IbrahimAyoub05/AIglasses/Cad Designs/Hero Models/Screenshot 2026-05-05 at 3.56.49 PM.png

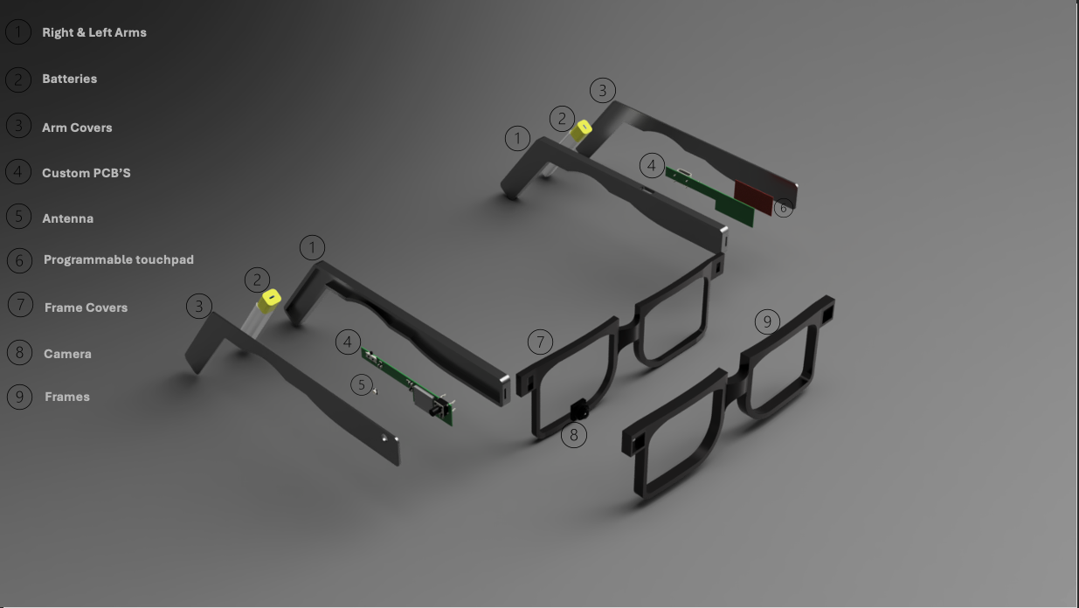
Cad Designs/Hero Models/Screenshot 2026-05-05 at 3.56.49 PM.png
