IbrahimAyoub05/AIglasses/Cad Designs/Older/Glasses 3D Design 1/Ibrahim Ayoub ECE Plan of Study copy.xlsx

Sheet: 4 yrs, 1 co-op (spring) (2)
 | B.S. in Electrical and Computer Engineering |  |  | CURRICULUM PLANNER |  | DEGREE CLEARANCE FORM
 | 4 years, 1 co-op in Spring/Summer 1 [DA Pattern] |  | > Hover over a course to view prerequisites, frequency, and other advising notes. |  |  | >After pasting completed courses into the Degree Clearance Form, fill in the grade and credits earned.
 | This sheet is a planning tool, but is not meant to substitute for the degree audit and catalog. It is the student's responsibility to check their degree audit to ensure that degree requirements are being met.
 | Please refer to the academic catalog for more detailed information on each course (https://catalog.northeastern.edu/) |  | > Cut and paste course cells if moving to a different semester |  |  | > Transfer credit grades: College = 'T', Advanced Placement = 'AP', International Baccalaureate = 'IB'
 | Name: Ibrahim Ayoub |  | > Cut and paste course cells into the Degree Clearance Form when completed
 | Student ID: |  |  |  |  | > Be sure to accurately indicate total Northeastern credits awarded for transfer and study abroad courses.
 | Year of Graduation: |  | > Before making any changes, read important advising notes at bottom of document.
 | Capstone: |  |  |  |  | > Input course numbers for all elective coursework
 | FALL (YEAR) | SPRING | SUMMER 1 | SUMMER 2 |  | MATH & SCIENCE |  | GRADE | TOTAL CREDITS | MATH/SCI CREDITS | ENG'G CREDITS
 | NOTES: | NOTES: | NOTES: | NOTES:
YEAR 1 |  |  |  |  | YEAR 1 | CHEM1151 > | CHEM1151 Chem for Eng. 4cr |  |  | 4
 |  |  |  |  |  | CHEM1153 > | CHEM1153 Recitation
 |  |  |  |  |  | CS1800 > |  |  |  | 4
 |  |  |  |  |  | CS1802 > |  |  |  | 1
 |  |  |  |  |  | MATH1341 > | MATH1341 Calc 1 for Eng. 4cr |  |  | 4
 |  |  |  |  |  | MATH1342 > | MATH1342 Calc 2 for Eng. 4cr |  |  | 4
 |  |  |  |  |  | MATH2321 > | MATH2321 Calc 3 for Eng. 4cr |  |  | 4
 |  |  |  |  |  | MATH2341 > | MATH2341 Diff Eq/Lin. Alg. 4cr |  |  | 4
 | FALL | SPRING | SUMMER 1 | SUMMER 2 |  | PHYS1151 > | PHYS1151 Phys 1 for Eng. 3cr |  |  | 3
 | NOTES: | NOTES: | NOTES: | NOTES: |  | PHYS1152 > | PHYS1152 Phys 1 lab 1cr |  |  | 1
YEAR 2 |  |  |  |  | YEAR 2 | PHYS1153 > | PHYS1153 Physics ILS 1cr |  |  | 1
 |  |  |  |  |  | PHYS1155 > | PHYS1155 Phys 2 for Eng. 3cr |  |  | 3
 |  |  |  |  |  | PHYS1156 > | PHYS1156 Phys 2 lab 1cr |  |  | 1
 |  |  |  |  |  | PHYS1157 > | PHYS1157 Physics 2 ILS 1cr |  |  | 1
 |  |  |  |  |  | ENGI- NEERING |  | GRADE | TOTAL CREDITS | MATH/SCI CREDITS | ENG'G CREDITS
 | FALL | SPRING | SUMMER 1 | SUMMER 2 |  | EECE2140 | EECE2140 Computing Fundamentals for Engineers 4cr |  |  |  | 4
 | NOTES: | NOTES: | NOTES: | NOTES: SUBMIT UPDATED PLAN TO ADVISOR FOR CLEARANCE REVIEW. |  | EECE2150 | EECE2150 Circuits & Signals 5cr |  |  |  | 5
YEAR 3 |  | CO-OP | CO-OP |  | YEAR 3 | EECE2160 | EECE2160 Embedded Design 4cr |  |  |  | 4
 |  |  |  |  |  | Required: 3 EE Fundamentals
 |  |  |  |  |  | EECE2412 | EECE2412/13 Fundamentals of Electronics |  |  |  | 4
 |  |  |  |  |  | EECE2413 lab | EECE2413 lab |  |  |  | 1
 |  |  |  |  |  | EECE2520 | X |  |  |  | 4
 |  |  |  |  |  | EECE2530 | x |  |  |  | 4
 |  |  |  |  |  | EECE2531 lab | x |  |  |  | 1
 |  |  |  |  |  | Required: 3 CE Fundamentals
 | FALL | SPRING | Summer | Fall |  | EECE2322 | x |  |  |  | 4
 | NOTES: | NOTES: | NOTES: | NOTES: |  | EECE2323 lab | x |  |  |  | 1
YEAR 4 | EECE2520 Fundamentals of Linear Systems | EECExxxx EECE Tech Elective 4 4cr | EECE4791 Capstone 1 |  | YEAR 4 | EECE2540 | Fundimentals of netwroks 2540 |  |  |  | 4
 | EECE2322/23 Digital Design |  | XXXX____ > | EECE3468 Noise & Stoch. Pro. 4cr |  | EECE2560 | EECExxxx EE/CE Fund 4/5cr |  |  |  | 4
 | EECE2323 lab | EECExxxx EECE Tech Elective 6 4cr | EECExxxx EECE Tech Elective 5 4cr | EECE4792 Capstone 2 4cr |  | CAPSTONE
 | CS 3200Introduction to Databases 4cr |  | EECE2530 Elctromagnetics | ENCP3000 Prof. Issues 1cr |  | EECE4791 |  |  |  |  | 1
 | EECE2750 Enabiling Engineering 4cr |  | EECE2531 lab |  |  | EECE4792 |  |  |  |  | 4
 |  |  |  |  |  | TECH. ELECT.
 |  |  |  |  |  | EECExxxx |  |  |  |  | 4
 |  |  |  |  |  | EECExxxx |  |  |  |  | 4
 | ADVISING NOTES |  |  |  |  | EECExxxx |  |  |  |  | 4
 |  |  |  |  |  | EECExxxx |  |  |  |  | 4
# | <-- Click to view degree requirements in the catalog, including elective options not specified. |  |  |  |  | ADD'L ENG.
 | > The following NU Path requirements to be completed with General Electives: Interpreting Culture (IC), Difference & Diversity (DD) and Societies & Institutions (SI). |  |  |  |  | GE 1501 > | GE 1501 Cornerstone 1 4cr |  |  |  | 3
 | > Always plan to register for at least 16 credits in a semester (+ required labs/recitations). |  |  |  |  | GE 1502 > | GE 1502 Cornerstone 2 4cr |  |  | 1 | 3
 | > Students with less than 12 billing credits remaining in their curriculum in their final semester are eligible to submit a petition to reduce load |  |  |  |  | EECE3468 |  |  |  | 2 | 2
 | via the StudentHub--> Academics, Classes, and Registration --> Registrar Forms. Submit the petition after registering for final degree requirements.
 | > Keep semester loads balanced. For instance, try to evenly distribute general electives, writing courses and non-engineering coursework.
 | > Course availability as listed is subject to change depending on departmental offerings. Students should always check the projected course offerings
 | as well as the semester schedule prior to registration. |  |  |  |  | PROF. DVLPMT. |  | GRADE | TOTAL CREDITS
 | > This sheet is a planning tool, but is not meant to substitute for the degree audit and catalog. It is the student's responsibility to check their degree audit to ensure
 | that degree requirements are being met. |  |  |  |  | GE 1000 > | GE 1000 First-Year Seminar 1cr
 | >A minimum cumulative GPA requirement of 2.000 in major coursework and a minimum cumulative GPA requirement of 2.000 overall are required for graduation. |  |  |  |  | EECE2000 >
 | Requirements Specific to Combined Electrical & Computer Engr. Majors |  |  |  |  | EECE3000 >
 |  |  |  |  |  | SUPP. COURSES |  | GRADE | TOTAL CREDITS
 | 1. The Capstone Design Courses are taken as follows: (EECE4790 - Summer 1 and EECE4792 - Spring) OR (EECE4790 - Summer 2 and EECE4792 - Fall)
 | 2. For engineering majors, ENGW3315 is an acceptable substitution for ENGW3302. |  |  |  |  | ENGW1111 > | ENGW1111 1st Year Writ. 4cr
 | 3. NUpath requirements, Interpreting Culture (IC), Societies and Institutions (SI) and Differences and Diversity (DD) are not explicitly satisfied by required |  |  |  |  | ENGW3302 >
 | engineering courses. Students are responsible for satisfying these requirements, and if these are not fulfilled in engineering courses, should use General |  |  |  |  | or 3315
 | Electives to do so. General Electives are academic, non-remedial, non-repetitive courses. Should you choose not to pursue a co-op experience, you are
 | required to satisfy the Integration Experience (EX) NUpath requirement through other coursework.
 | 4. Total Required General Elective Credits: 16 |  |  |  |  | GENERAL ELECTIVES | X' the box for each NU Path requirement when it is complete. | GRADE | TOTAL CREDITS | IC | DD | SI
 | 5. Three (3) Required CE Fundamentals:
 | EECE2322/2323 - Fundamentals Digital Design & Lab AND EECE2540 - Fundamentals Networks AND EECE2560 - Fundamentals Algorithms |  |  |  |  | XXXX____ > | XXXX____ Gen Elective 1 4cr |  |  |  | x
 | 6. Three (3) Required EE Fundamentals: |  |  |  |  | XXXX____ > | XXXX____ Gen Elective 2 4cr |  |  | X |  | X
 | EECE2412/2413 - Fundamentals Electronics 1 & lab AND EECE2520 - Fundamentals Linear Systems AND EECE 2530/2531 - Fundamentals Electromagnetics & lab. |  |  |  |  | XXXX____ >
 | 7. Technical Elective Requirements: 2 EECE Technical Electives and 2 Khoury College of Computer Sciences (CS) Technical Electives: |  |  |  |  | XXXX____ >
 | 2 EECE courses from the following approved list: |  |  |  |  |  | ENCP2000 Intro. To Co-op 1cr
 | EECE2750, EECE3154, (EECE3324-EECE3410), ( EECE4512-EECE4698), (EECE4991-EECE4993), (EECE5155-EECE5698), GE4608, ENGR5670
 | 2 CS/CY/IS courses from the following approved list:
 | CY2550, (CS3200-CS3500), (CS3540-CS3800), (CS4100-CY4770), CS4850, (IS4200- IS4700)
 | 8. The registrar’s website provides a listing of degree requirements and the DARS system provides a degree audit utility for students.
 |  |  |  |  |  | MATH/SCIENCE CREDITS |  | MINIMUM |  |  | 30
 |  |  |  |  |  |  |  | EARNED |  |  | 0
 |  |  |  |  |  | ENGINEERING CREDITS |  | REQUIRED |  |  | 68
 | Notes: |  | Minor (optional): |  |  |  |  | EARNED |  |  | 0
 |  |  | Minor Advisor/Email: |  |  | TOTAL CREDITS |  | REQUIRED |  |  | 135
 |  |  | REQUIRED COURSES COMPLETED |  |  |  |  | EARNED |  |  | 0
 |  |  |  |  |  | AP/IB CREDITS
 |  |  |  |  |  | STUDENTS ARE ALLOWED TO COUNT A MAXIMUM OF 32 CREDITS FROM AP/IB COURSES TOWARD TOTAL CREDIT REQUIREMENT. ANY CREDITS OVER THE LIMIT MUST BE MADE UP WITH ADDITIONAL GENERAL ELECTIVE COURSEWORK.
 | REMOTE CAPSTONE DESIGN POLICY |  |  |  |  |  |  | EARNED |  |  | 0
 |  |  |  |  |  |  |  | ALLOWED |  |  | 32
 | The capstone design course is a team effort, and students should try their best to be on-campus working with their team members. Capstone consists of two courses, Capstone 1 (EECE 4790) and Capstone 2 (EECE 4792). Capstone 1 is offered during summer, and it is divided into two sections. Students in the summer 1 section will continue capstone 2 in the spring of the following year and students in the summer 2 section will continue capstone 2 in the fall of the same year. We allow students to take capstone 1 remotely with valid reasoning. However, all students must be on-campus for capstone 2. During the first week of summer 1 or summer 2, we will have an assembly meeting, in which teams are created and advisors are associated with them. Each team consisting of 5 or 6 students is required to meet with the assigned advisor every week for one hour. The advisor usually has five teams and meets with each team at a mutually agreeable time once a week. Note that students will not meet at the designated scheduled classes every day after the first week. However, it is expected that each team arranges more meetings per week (at school or remotely) to be actively involved with the project. |  |  |  |  |  |  | DIFFERENCE
 | The following rules apply for students who are taking capstone remotely:
 | 1. The remote student should submit an email to the Capstone Coordinator, Professor Bahram Shafai (shafai@ece.neu.edu), at least one month before the start of the Capstone 1 term explaining the reason for not being available on campus. Most of the cases can be resolved by communications. | 2. The remote student must attend the assembly meeting(s) in person during the first week before committing to any summer internship, job, family visit or travel. | 3. If the remote student is not available at the assembly meeting(s), the student is responsible for finding a capstone team in advance to represent the student at the meeting. | 4. If the remote student cannot find a complete team, then the student should find one or more students to represent the remote student at the assembly meeting. | 5. The remote student will be placed in a capstone team if this student cannot form a team.
 | 6. The remote student should arrange to be available during the weekly meeting with the capstone advisor and have full agreement from the team that this arrangement is acceptable. | 7. The student should identify personal responsibilities for the capstone team. | 8. The remote student must attend the final proposal presentation in person at the end of the summer session. | 9. If the remote student is not available on-campus for final proposal presentation, then the student can remotely present or integrate their presentation with a short video-clip in the PowerPoint slides. | If there are additional questions or concerns, please contact Professor Bahram Shafai by email: shafai@ece.neu.edu or Cell: (617)721-4805.
 | FALL | SPRING | SUMMER 1 | SUMMER 2
 | NOTES: | NOTES: | NOTES: | NOTES:
YEAR 4 | EECE4791 Capstone 1 1cr | EECE4792 Capstone 2 4cr |  |  | YEAR 4
 | EECExxxx EECE Tech Elective 4 4cr | EECE3468 Noise & Stoch. Pro. 4cr
 | EECExxxx EECE Tech Elective 3 4cr | EECExxxx EE/CE Fund 4/5cr
 |  | EECExxxx EECE Tech Elective 2 4cr
 |  | ENCP3000 Prof. Issues 1cr

Sheet: 4 yrs, 2 co-op (spring)
 | B.S. in Electrical and Computer Engineering |  |  | CURRICULUM PLANNER |  | DEGREE CLEARANCE FORM
 | 4 years, 1 co-op in Spring/Summer 1 [DA Pattern] |  | > Hover over a course to view prerequisites, frequency, and other advising notes. |  |  | >After pasting completed courses into the Degree Clearance Form, fill in the grade and credits earned.
 | This sheet is a planning tool, but is not meant to substitute for the degree audit and catalog. It is the student's responsibility to check their degree audit to ensure that degree requirements are being met.
 | Please refer to the academic catalog for more detailed information on each course (https://catalog.northeastern.edu/) |  | > Cut and paste course cells if moving to a different semester |  |  | > Transfer credit grades: College = 'T', Advanced Placement = 'AP', International Baccalaureate = 'IB'
 | Name: Ibrahim Ayoub |  | > Cut and paste course cells into the Degree Clearance Form when completed
 | Student ID: |  |  |  |  | > Be sure to accurately indicate total Northeastern credits awarded for transfer and study abroad courses.
 | Year of Graduation: |  | > Before making any changes, read important advising notes at bottom of document.
 | Capstone: |  |  |  |  | > Input course numbers for all elective coursework
 | B.S. in Electrical and Computer Engineering |  |  | CURRICULUM PLANNER |  | MATH & SCIENCE |  | GRADE | TOTAL CREDITS | MATH/SCI CREDITS | ENG'G CREDITS
 | 4 years, 1 co-op in Spring/Summer 1 [DA Pattern] |  | > Hover over a course to view prerequisites, frequency, and other advising notes.
YEAR 1 | This sheet is a planning tool, but is not meant to substitute for the degree audit and catalog. It is the student's responsibility to check their degree audit to ensure that degree requirements are being met. |  |  |  |  | CHEM1151 > | CHEM1151 Chem for Eng. 4cr |  |  | 4
 | Please refer to the academic catalog for more detailed information on each course (https://catalog.northeastern.edu/) |  | > Cut and paste course cells if moving to a different semester |  |  | CHEM1153 > | CHEM1153 Recitation
 | Name: Ibrahim Ayoub |  | > Cut and paste course cells into the Degree Clearance Form when completed |  |  | CS1800 > |  |  |  | 4
 | Student ID: |  |  |  |  | CS1802 > |  |  |  | 1
 | Year of Graduation: |  | > Before making any changes, read important advising notes at bottom of document. |  |  | MATH1341 > | MATH1341 Calc 1 for Eng. 4cr |  |  | 4
 | Capstone: |  |  |  |  | MATH1342 > | MATH1342 Calc 2 for Eng. 4cr |  |  | 4
 | FALL (YEAR) | SPRING | SUMMER 1 | SUMMER 2 |  | MATH2321 > |  |  |  | 4
 | NOTES: | NOTES: | NOTES: | NOTES: |  | MATH2341 > |  |  |  | 4
 |  |  |  |  | YEAR 1 | PHYS1151 > | PHYS1151 Phys 1 for Eng. 3cr |  |  | 3
 |  |  |  |  |  | PHYS1152 > | PHYS1152 Phys 1 lab 1cr |  |  | 1
YEAR 2 |  |  |  |  |  | PHYS1153 > | PHYS1153 Physics ILS 1cr |  |  | 1
 |  |  |  |  |  | PHYS1155 > |  |  |  | 3
 |  |  |  |  |  | PHYS1156 > |  |  |  | 1
 |  |  |  |  |  | PHYS1157 > |  |  |  | 1
 | FALL | SPRING | SUMMER 1 | SUMMER 2 |  | ENGI- NEERING |  | GRADE | TOTAL CREDITS | MATH/SCI CREDITS | ENG'G CREDITS
 | NOTES: | NOTES: | NOTES: | NOTES:
 |  |  |  |  | YEAR 2 | EECE2140 |  |  |  |  | 4
 |  |  |  |  |  | EECE2150 |  |  |  |  | 5
YEAR 3 |  |  |  |  |  | EECE2160 |  |  |  |  | 4
 |  |  |  |  |  | Required: 3 EE Fundamentals
 |  |  |  |  |  | EECE2412 |  |  |  |  | 4
 |  |  |  |  |  | EECE2413 lab |  |  |  |  | 1
 |  |  |  |  |  | EECE2520 |  |  |  |  | 4
 |  |  |  |  |  | EECE2530 |  |  |  |  | 4
 | FALL | SPRING | SUMMER 1 | SUMMER 2 |  | EECE2531 lab |  |  |  |  | 1
 | NOTES: | NOTES: | NOTES: | NOTES: SUBMIT UPDATED PLAN TO ADVISOR FOR CLEARANCE REVIEW. |  | Required: 3 CE Fundamentals
 | Fundimentals of netwroks 2540 | EECE2520 Fundamentals of Linear Systems | EECE4791 Capstone 1 |  | YEAR 3 | EECE2322 |  |  |  |  | 4
 | EECE2412/13 Fundamentals of Electronics | EECE2322/23 Digital Design | XXXX____ > |  |  | EECE2323 lab |  |  |  |  | 1
YEAR 4 | EECE2413 lab | EECE2323 lab |  |  |  | EECE2540 |  |  |  |  | 4
 | CS1800 Discrete Structures 4cr | EECExxxx EECE Tech Elective 2 4cr |  |  |  | EECE2560 |  |  |  |  | 4
 | CS1802 Recitation 1cr | EECExxxx EECE Tech Elective 3 4cr |  |  |  | CAPSTONE
 |  | ENCP3000 Prof. Issues 1cr |  |  |  | EECE4791 |  |  |  |  | 1
 |  |  |  |  |  | EECE4792 |  |  |  |  | 4
 |  |  |  |  |  | TECH. ELECT.
 | FALL | SPRING | Fall | Spring |  | EECExxxx |  |  |  |  | 4
 | NOTES: | NOTES: | NOTES: | NOTES: |  | EECExxxx |  |  |  |  | 4
 | EECExxxx EECE Tech Elective 4 4cr | EECE4792 Capstone 2 4cr |  |  | YEAR 4 | EECExxxx |  |  |  |  | 4
 | EECE2530 Elctromagnetics | EECE3468 Noise & Stoch. Pro. 4cr |  |  |  | EECExxxx |  |  |  |  | 4
# | EECE2531 lab | EECExxxx EECE Tech Elective 5 4cr |  |  |  | ADD'L ENG.
 | EECExxxx EECE Tech Elective 6 4cr | ENCP3000 Prof. Issues 1cr |  |  |  | GE 1501 > |  |  |  |  | 3
 |  |  |  |  |  | GE 1502 > |  |  |  | 1 | 3
 |  |  |  |  |  | EECE3468 |  |  |  | 2 | 2
 | > Course availability as listed is subject to change depending on departmental offerings. Students should always check the projected course offerings
 | as well as the semester schedule prior to registration. |  |  |  |  | PROF. DVLPMT. |  | GRADE | TOTAL CREDITS
 | > This sheet is a planning tool, but is not meant to substitute for the degree audit and catalog. It is the student's responsibility to check their degree audit to ensure
 | that degree requirements are being met. |  |  |  |  | GE 1000 > | GE 1000 First-Year Seminar 1cr
 | >A minimum cumulative GPA requirement of 2.000 in major coursework and a minimum cumulative GPA requirement of 2.000 overall are required for graduation. |  |  |  |  | EECE2000 >
 | Requirements Specific to Combined Electrical & Computer Engr. Majors |  |  |  |  | EECE3000 >
 |  |  |  |  |  | SUPP. COURSES |  | GRADE | TOTAL CREDITS
 | 1. The Capstone Design Courses are taken as follows: (EECE4790 - Summer 1 and EECE4792 - Spring) OR (EECE4790 - Summer 2 and EECE4792 - Fall)
 | 2. For engineering majors, ENGW3315 is an acceptable substitution for ENGW3302. |  |  |  |  | ENGW1111 >
 | 3. NUpath requirements, Interpreting Culture (IC), Societies and Institutions (SI) and Differences and Diversity (DD) are not explicitly satisfied by required |  |  |  |  | ENGW3302 >
 | engineering courses. Students are responsible for satisfying these requirements, and if these are not fulfilled in engineering courses, should use General |  |  |  |  | or 3315
 | Electives to do so. General Electives are academic, non-remedial, non-repetitive courses. Should you choose not to pursue a co-op experience, you are
 | required to satisfy the Integration Experience (EX) NUpath requirement through other coursework.
 | 4. Total Required General Elective Credits: 16 |  |  |  |  | GENERAL ELECTIVES | X' the box for each NU Path requirement when it is complete. | GRADE | TOTAL CREDITS | IC | DD | SI
 | 5. Three (3) Required CE Fundamentals:
 | EECE2322/2323 - Fundamentals Digital Design & Lab AND EECE2540 - Fundamentals Networks AND EECE2560 - Fundamentals Algorithms |  |  |  |  | XXXX____ > | XXXX____ Gen Elective 1 4cr
 | 6. Three (3) Required EE Fundamentals: |  |  |  |  | XXXX____ > | XXXX____ Gen Elective 2 4cr |  |  | X |  | X
 | EECE2412/2413 - Fundamentals Electronics 1 & lab AND EECE2520 - Fundamentals Linear Systems AND EECE 2530/2531 - Fundamentals Electromagnetics & lab. |  |  |  |  | XXXX____ >
 | 7. Technical Elective Requirements: 2 EECE Technical Electives and 2 Khoury College of Computer Sciences (CS) Technical Electives: |  |  |  |  | XXXX____ >
 | 2 EECE courses from the following approved list:
 | EECE2750, EECE3154, (EECE3324-EECE3410), ( EECE4512-EECE4698), (EECE4991-EECE4993), (EECE5155-EECE5698), GE4608, ENGR5670
 | 2 CS/CY/IS courses from the following approved list:
 | CY2550, (CS3200-CS3500), (CS3540-CS3800), (CS4100-CY4770), CS4850, (IS4200- IS4700)
 | 8. The registrar’s website provides a listing of degree requirements and the DARS system provides a degree audit utility for students.
 |  |  |  |  |  | MATH/SCIENCE CREDITS |  | MINIMUM |  |  | 30
 |  |  |  |  |  |  |  | EARNED |  |  | 0
 |  |  |  |  |  | ENGINEERING CREDITS |  | REQUIRED |  |  | 68
 | Notes: |  | Minor (optional): |  |  |  |  | EARNED |  |  | 0
 |  |  | Minor Advisor/Email: |  |  | TOTAL CREDITS |  | REQUIRED |  |  | 135
 |  |  | REQUIRED COURSES COMPLETED |  |  |  |  | EARNED |  |  | 0
 |  |  |  |  |  | AP/IB CREDITS
 |  |  |  |  |  | STUDENTS ARE ALLOWED TO COUNT A MAXIMUM OF 32 CREDITS FROM AP/IB COURSES TOWARD TOTAL CREDIT REQUIREMENT. ANY CREDITS OVER THE LIMIT MUST BE MADE UP WITH ADDITIONAL GENERAL ELECTIVE COURSEWORK.
 | REMOTE CAPSTONE DESIGN POLICY |  |  |  |  |  |  | EARNED |  |  | 0
 |  |  |  |  |  |  |  | ALLOWED |  |  | 32
 | The capstone design course is a team effort, and students should try their best to be on-campus working with their team members. Capstone consists of two courses, Capstone 1 (EECE 4790) and Capstone 2 (EECE 4792). Capstone 1 is offered during summer, and it is divided into two sections. Students in the summer 1 section will continue capstone 2 in the spring of the following year and students in the summer 2 section will continue capstone 2 in the fall of the same year. We allow students to take capstone 1 remotely with valid reasoning. However, all students must be on-campus for capstone 2. During the first week of summer 1 or summer 2, we will have an assembly meeting, in which teams are created and advisors are associated with them. Each team consisting of 5 or 6 students is required to meet with the assigned advisor every week for one hour. The advisor usually has five teams and meets with each team at a mutually agreeable time once a week. Note that students will not meet at the designated scheduled classes every day after the first week. However, it is expected that each team arranges more meetings per week (at school or remotely) to be actively involved with the project. |  |  |  |  |  |  | DIFFERENCE
 | The following rules apply for students who are taking capstone remotely:
 | 1. The remote student should submit an email to the Capstone Coordinator, Professor Bahram Shafai (shafai@ece.neu.edu), at least one month before the start of the Capstone 1 term explaining the reason for not being available on campus. Most of the cases can be resolved by communications. | 2. The remote student must attend the assembly meeting(s) in person during the first week before committing to any summer internship, job, family visit or travel. | 3. If the remote student is not available at the assembly meeting(s), the student is responsible for finding a capstone team in advance to represent the student at the meeting. | 4. If the remote student cannot find a complete team, then the student should find one or more students to represent the remote student at the assembly meeting. | 5. The remote student will be placed in a capstone team if this student cannot form a team.
 | 6. The remote student should arrange to be available during the weekly meeting with the capstone advisor and have full agreement from the team that this arrangement is acceptable. | 7. The student should identify personal responsibilities for the capstone team. | 8. The remote student must attend the final proposal presentation in person at the end of the summer session. | 9. If the remote student is not available on-campus for final proposal presentation, then the student can remotely present or integrate their presentation with a short video-clip in the PowerPoint slides. | If there are additional questions or concerns, please contact Professor Bahram Shafai by email: shafai@ece.neu.edu or Cell: (617)721-4805.

Sheet: 4 yrs, 1 co-op (fall)
 | B.S. in Electrical and Computer Engineering |  |  | CURRICULUM PLANNER |  | DEGREE CLEARANCE FORM
 | 4 years, 1 co-op in Summer 2/Fall [DB Pattern] |  | > Hover over a course to view prerequisites, frequency, and other advising notes. |  |  | >After pasting completed courses into the Degree Clearance Form, fill in the grade and credits earned.
 | This sheet is a planning tool, but is not meant to substitute for the degree audit and catalog. It is the student's responsibility to check their degree audit to ensure that degree requirements are being met.
 | Please refer to the academic catalog for more detailed information on each course (https://catalog.northeastern.edu/) |  | > Cut and paste course cells if moving to a different semester |  |  | > Transfer credit grades: College = 'T', Advanced Placement = 'AP', International Baccalaureate = 'IB'
 | Name: |  | > Cut and paste course cells into the Degree Clearance Form when completed
 | Student ID: |  |  |  |  | > Be sure to accurately indicate total Northeastern credits awarded for transfer and study abroad courses.
 | Year of Graduation: |  | > Before making any changes, read important advising notes at bottom of document.
 | Capstone: |  |  |  |  | > Input course numbers for all elective coursework
 | FALL (YEAR) | SPRING | SUMMER 1 | SUMMER 2 |  | MATH & SCIENCE |  | GRADE | TOTAL CREDITS | MATH/SCI CREDITS | ENG'G CREDITS
 | NOTES: | NOTES: | NOTES: | NOTES:
YEAR 1 | MATH1341 Calc 1 for Eng. 4cr | MATH1342 Calc 2 for Eng. 4cr | MATH2341 Diff Eq/Lin. Alg. 4cr |  | YEAR 1 | CHEM1151 > |  |  |  | 4
 | CHEM1151 Chem for Eng. 4cr | PHYS1151 Phys 1 for Eng. 3cr |  |  |  | CHEM1153 >
 | CHEM1153 Recitation | PHYS1152 Phys 1 lab 1cr |  |  |  | CS1800 > |  |  |  | 4
 | GE 1000 First-Year Seminar 1cr | PHYS1153 Physics ILS 1cr |  |  |  | CS1802 > |  |  |  | 1
 | GE 1501 Cornerstone 1 4cr | GE 1502 Cornerstone 2 4cr |  |  |  | MATH1341 > |  |  |  | 4
 | ENGW1111 1st Year Writ. 4cr | XXXX____ Gen Elective 1 4cr |  |  |  | MATH1342 > |  |  |  | 4
 |  |  |  |  |  | MATH2321 > |  |  |  | 4
 |  |  |  |  |  | MATH2341 > |  |  |  | 4
 | FALL | SPRING | SUMMER 1 | SUMMER 2 |  | PHYS1151 > |  |  |  | 3
 | NOTES: | NOTES: | NOTES: | NOTES: |  | PHYS1152 > |  |  |  | 1
YEAR 2 | MATH2321 Calc 3 for Eng. 4cr | CS1800 Discrete Structures 4cr |  | CO-OP | YEAR 2 | PHYS1153 > |  |  |  | 1
 | PHYS1155 Phys 2 for Eng. 3cr | CS1802 Recitation 1cr |  |  |  | PHYS1155 > |  |  |  | 3
 | PHYS1156 Phys 2 lab 1cr | EECE2150 Circuits & Signals 5cr OR EECE2160 Embedded Design 4cr |  |  |  | PHYS1156 > |  |  |  | 1
 | PHYS1157 Physics 2 ILS 1cr | EECExxxx EE/CE Fund. 4/5cr |  |  |  | PHYS1157 > |  |  |  | 1
 | EECE2150 Circuits & Signals 5cr OR EECE2160 Embedded Design 4cr | XXXX____ Gen Elective 2 4cr
 | EECE2140 Computing Fundamentals for Engineers 4cr | ENCP2000 Intro. To Co-op 1cr
 |  |  |  |  |  | ENGI- NEERING |  | GRADE | TOTAL CREDITS | MATH/SCI CREDITS | ENG'G CREDITS
 | FALL | SPRING | SUMMER 1 | SUMMER 2 |  | EECE2140 |  |  |  |  | 4
 | NOTES: | NOTES: | NOTES: | NOTES: SUBMIT UPDATED PLAN TO ADVISOR FOR CLEARANCE REVIEW. |  | EECE2150 |  |  |  |  | 5
YEAR 3 | CO-OP | EECExxxx EE/CE Fund 4/5cr | EECE4791 Capstone 1 1cr |  | YEAR 3 | EECE2160 |  |  |  |  | 4
 |  | EECExxxx EE/CE Fund 4/5cr | EECExxxx Technical Elective 1 4cr |  |  | Required: 3 EE Fundamentals
 |  | EECExxxx EE/CE Fund 4/5cr | ENGW3302 Adv. Writ.: Tech Prof 4cr |  |  | EECE2412 |  |  |  |  | 4
 |  | XXXX____ Gen Elective 3 4cr | or 3315 Interdisciplinary Adv. Writ. |  |  | EECE2413 lab |  |  |  |  | 1
 |  | ENCP3000 Prof. Issues 1cr |  |  |  | EECE2520 |  |  |  |  | 4
 |  |  |  |  |  | EECE2530 |  |  |  |  | 4
 |  |  |  |  |  | EECE2531 lab |  |  |  |  | 1
 |  |  |  |  |  | Required: 3 CE Fundamentals
 | FALL | SPRING | SUMMER 1 | SUMMER 2 |  | EECE2322 |  |  |  |  | 4
 | NOTES: | NOTES: | NOTES: | NOTES: |  | EECE2323 lab |  |  |  |  | 1
YEAR 4 | EECE3468 Noise & Stoch. Pro. 4cr | EECE4792 Capstone 2 4cr |  |  | YEAR 4 | EECE2540 |  |  |  |  | 4
 | EECExxxx EE/CE Fund 4/5cr | EECExxxx EECE Tech Elective 3 4cr |  |  |  | EECE2560 |  |  |  |  | 4
 | EECExxxx EE/CE Fund 4/5cr | EECExxxx EECE Tech Elective 4 4cr |  |  |  | CAPSTONE
 | EECExxxx EECE Tech Elective 2 4cr | XXXX____ Gen Elective 4 4cr |  |  |  | EECE4791 |  |  |  |  | 1
 |  |  |  |  |  | EECE4792 |  |  |  |  | 4
 |  |  |  |  |  | TECH. ELECT.
 |  |  |  |  |  | EECExxxx |  |  |  |  | 4
 |  |  |  |  |  | EECExxxx |  |  |  |  | 4
 | ADVISING NOTES |  |  |  |  | EECExxxx |  |  |  |  | 4
 |  |  |  |  |  | EECExxxx |  |  |  |  | 4
# | <-- Click to view degree requirements in the catalog, including elective options not specified. |  |  |  |  | ADD'L ENG.
 | > The following NU Path requirements to be completed with General Electives: Interpreting Culture (IC), Difference & Diversity (DD) and Societies & Institutions (SI). |  |  |  |  | GE 1501 > |  |  |  |  | 3
 | > Always plan to register for at least 16 credits in a semester (+ required labs/recitations). |  |  |  |  | GE 1502 > |  |  |  | 1 | 3
 | > Students with less than 12 billing credits remaining in their curriculum in their final semester are eligible to submit a petition to reduce load |  |  |  |  | EECE3468 |  |  |  | 2 | 2
 | via the StudentHub--> Academics, Classes, and Registration --> Registrar Forms. Submit the petition after registering for final degree requirements.
 | > Keep semester loads balanced. For instance, try to evenly distribute general electives, writing courses and non-engineering coursework.
 | > Course availability as listed is subject to change depending on departmental offerings. Students should always check the projected course offerings
 | as well as the semester schedule prior to registration. |  |  |  |  | PROF. DVLPMT. |  | GRADE | TOTAL CREDITS
 | > This sheet is a planning tool, but is not meant to substitute for the degree audit and catalog. It is the student's responsibility to check their degree audit to ensure
 | that degree requirements are being met. |  |  |  |  | GE 1000 >
 | >A minimum cumulative GPA requirement of 2.000 in major coursework and a minimum cumulative GPA requirement of 2.000 overall are required for graduation. |  |  |  |  | EECE2000 >
 | Requirements Specific to Combined Electrical & Computer Engr. Majors |  |  |  |  | EECE3000 >
 |  |  |  |  |  | SUPP. COURSES |  | GRADE | TOTAL CREDITS
 | 1. The Capstone Design Courses are taken as follows: (EECE4790 - Summer 1 and EECE4792 - Spring) OR (EECE4790 - Summer 2 and EECE4792 - Fall)
 | 2. For engineering majors, ENGW3315 is an acceptable substitution for ENGW3302. |  |  |  |  | ENGW1111 >
 | 3. NUpath requirements, Interpreting Culture (IC), Societies and Institutions (SI) and Differences and Diversity (DD) are not explicitly satisfied by required |  |  |  |  | ENGW3302 >
 | engineering courses. Students are responsible for satisfying these requirements, and if these are not fulfilled in engineering courses, should use General |  |  |  |  | or 3315
 | Electives to do so. General Electives are academic, non-remedial, non-repetitive courses. Should you choose not to pursue a co-op experience, you are
 | required to satisfy the Integration Experience (EX) NUpath requirement through other coursework.
 | 4. Total Required General Elective Credits: 16 |  |  |  |  | GENERAL ELECTIVES | X' the box for each NU Path requirement when it is complete. | GRADE | TOTAL CREDITS | IC | DD | SI
 | 5. Three (3) Required CE Fundamentals:
 | EECE2322/2323 - Fundamentals Digital Design & Lab AND EECE2540 - Fundamentals Networks AND EECE2560 - Fundamentals Algorithms |  |  |  |  | XXXX____ >
 | 6. Three (3) Required EE Fundamentals: |  |  |  |  | XXXX____ >
 | EECE2412/2413 - Fundamentals Electronics 1 & lab AND EECE2520 - Fundamentals Linear Systems AND EECE 2530/2531 - Fundamentals Electromagnetics & lab. |  |  |  |  | XXXX____ >
 | 7. Technical Elective Requirements: 2 EECE Technical Electives and 2 Khoury College of Computer Sciences (CS) Technical Electives: |  |  |  |  | XXXX____ >
 | 2 EECE courses from the following approved list:
 | EECE2750, EECE3154, (EECE3324-EECE3410), ( EECE4512-EECE4698), (EECE4991-EECE4993), (EECE5155-EECE5698), GE4608, ENGR5670
 | 2 CS/CY/IS courses from the following approved list:
 | CY2550, (CS3200-CS3500), (CS3540-CS3800), (CS4100-CY4770), CS4850, (IS4200- IS4700)
 | 8. The registrar’s website provides a listing of degree requirements and the DARS system provides a degree audit utility for students.
 |  |  |  |  |  | MATH/SCIENCE CREDITS |  | MINIMUM |  |  | 30
 |  |  |  |  |  |  |  | EARNED |  |  | 0
 |  |  |  |  |  | ENGINEERING CREDITS |  | REQUIRED |  |  | 68
 | Notes: |  | Minor (optional): |  |  |  |  | EARNED |  |  | 0
 |  |  | Minor Advisor/Email: |  |  | TOTAL CREDITS |  | REQUIRED |  |  | 135
 |  |  | REQUIRED COURSES COMPLETED |  |  |  |  | EARNED |  |  | 0
 |  |  |  |  |  | AP/IB CREDITS
 |  |  |  |  |  | STUDENTS ARE ALLOWED TO COUNT A MAXIMUM OF 32 CREDITS FROM AP/IB COURSES TOWARD TOTAL CREDIT REQUIREMENT. ANY CREDITS OVER THE LIMIT MUST BE MADE UP WITH ADDITIONAL GENERAL ELECTIVE COURSEWORK.
 | REMOTE CAPSTONE DESIGN POLICY |  |  |  |  |  |  | EARNED |  |  | 0
 |  |  |  |  |  |  |  | ALLOWED |  |  | 32
 | The capstone design course is a team effort, and students should try their best to be on-campus working with their team members. Capstone consists of two courses, Capstone 1 (EECE 4790) and Capstone 2 (EECE 4792). Capstone 1 is offered during summer, and it is divided into two sections. Students in the summer 1 section will continue capstone 2 in the spring of the following year and students in the summer 2 section will continue capstone 2 in the fall of the same year. We allow students to take capstone 1 remotely with valid reasoning. However, all students must be on-campus for capstone 2. During the first week of summer 1 or summer 2, we will have an assembly meeting, in which teams are created and advisors are associated with them. Each team consisting of 5 or 6 students is required to meet with the assigned advisor every week for one hour. The advisor usually has five teams and meets with each team at a mutually agreeable time once a week. Note that students will not meet at the designated scheduled classes every day after the first week. However, it is expected that each team arranges more meetings per week (at school or remotely) to be actively involved with the project. |  |  |  |  |  |  | DIFFERENCE
 | The following rules apply for students who are taking capstone remotely:
 | 1. The remote student should submit an email to the Capstone Coordinator, Professor Bahram Shafai (shafai@ece.neu.edu), at least one month before the start of the Capstone 1 term explaining the reason for not being available on campus. Most of the cases can be resolved by communications. | 2. The remote student must attend the assembly meeting(s) in person during the first week before committing to any summer internship, job, family visit or travel. | 3. If the remote student is not available at the assembly meeting(s), the student is responsible for finding a capstone team in advance to represent the student at the meeting. | 4. If the remote student cannot find a complete team, then the student should find one or more students to represent the remote student at the assembly meeting. | 5. The remote student will be placed in a capstone team if this student cannot form a team.
 | 6. The remote student should arrange to be available during the weekly meeting with the capstone advisor and have full agreement from the team that this arrangement is acceptable. | 7. The student should identify personal responsibilities for the capstone team. | 8. The remote student must attend the final proposal presentation in person at the end of the summer session. | 9. If the remote student is not available on-campus for final proposal presentation, then the student can remotely present or integrate their presentation with a short video-clip in the PowerPoint slides. | If there are additional questions or concerns, please contact Professor Bahram Shafai by email: shafai@ece.neu.edu or Cell: (617)721-4805.

Sheet: 5 yrs, 3 co-ops (fall cycle)
 | B.S. in Electrical and Computer Engineering |  |  | CURRICULUM PLANNER |  |  | DEGREE CLEARANCE FORM
 | 5 years, 3 co-ops in Summer 2/Fall [AA Pattern] |  | > Hover over a course to view prerequisites, frequency, and other advising notes. |  |  |  | >After pasting completed courses into the Degree Clearance Form, fill in the grade and credits earned.
 | This sheet is a planning tool, but is not meant to substitute for the degree audit and catalog. It is the student's responsibility to check their degree audit to ensure that degree requirements are being met.
 | Please refer to the academic catalog for more detailed information on each course (https://catalog.northeastern.edu/) |  | > Cut and paste course cells if moving to a different semester |  |  |  | > Transfer credit grades: College = 'T', Advanced Placement = 'AP', International Baccalaureate = 'IB'
 | Name: |  | > Cut and paste course cells into the Degree Clearance Form when completed
 | Student ID: |  |  |  |  |  | > Be sure to accurately indicate total Northeastern credits awarded for transfer and study abroad courses.
 | Year of Graduation: |  | > Before making any changes, read important advising notes at bottom of document.
 | Capstone: |  |  |  |  |  | > Input course numbers for all elective coursework
 | FALL | SPRING | SUMMER 1 | SUMMER 2 |  |  | MATH & SCIENCE |  | GRADE | TOTAL CREDITS | MATH/SCI CREDITS | ENG'G CREDITS
 | NOTES: | NOTES: | NOTES: | NOTES:
YEAR 1 | MATH1341 Calc 1 for Eng. 4cr | MATH1342 Calc 2 for Eng. 4cr |  |  | YEAR 1 |  | CHEM1151 > |  |  |  | 4
 | CHEM1151 Chem for Eng. 4cr | PHYS1151 Phys 1 for Eng. 3cr |  |  |  |  | CHEM1153 >
 | CHEM1153 Recitation | PHYS1152 Phys 1 lab 1cr |  |  |  |  | CS1800 > |  |  |  | 4
 | GE 1000 First-Year Seminar 1cr | PHYS1153 Physics ILS 1cr |  |  |  |  | CS1802 > |  |  |  | 1
 | GE 1501 Cornerstone 1 4cr | GE 1502 Cornerstone 2 4cr |  |  |  |  | MATH1341 > |  |  |  | 4
 | ENGW1111 1st Year Writ. 4cr | XXXX____ Gen Elective 1 4cr |  |  |  |  | MATH1342 > |  |  |  | 4
 |  |  |  |  |  |  | MATH2321 > |  |  |  | 4
 |  |  |  |  |  |  | MATH2341 > |  |  |  | 4
 | FALL | SPRING | SUMMER 1 | SUMMER 2 |  |  | PHYS1151 > |  |  |  | 3
 | NOTES: | NOTES: | NOTES: | NOTES: |  |  | PHYS1152 > |  |  |  | 1
YEAR 2 | MATH2341 Diff Eq/Lin. Alg. 4cr | CS1800 Discrete Structures 4cr |  | CO-OP | YEAR 2 |  | PHYS1153 > |  |  |  | 1
 | PHYS1155 Phys 2 for Eng. 3cr | CS1802 Recitation 1cr |  |  |  |  | PHYS1155 > |  |  |  | 3
 | PHYS1156 Phys 2 lab 1cr | MATH2321 Calc 3 for Eng. 4cr |  |  |  |  | PHYS1156 > |  |  |  | 1
 | PHYS1157 Physics 2 ILS 1cr | ENCP2000 Intro. To Co-op 1cr |  |  |  |  | PHYS1157 > |  |  |  | 1
 | EECE2150 Circuits & Signals 5cr OR EECE2160 Embedded Design 4cr | EECE2150 Circuits & Signals 5cr OR EECE2160 Embedded Design 4cr
 | EECE2140 Computing Fundamentals for Engineers 4cr | EECExxxx EE/CE Fund. 4/5cr
 |  |  |  |  |  |  | ENGI- NEERING |  | GRADE | TOTAL CREDITS | MATH/SCI CREDITS | ENG'G CREDITS
 | FALL | SPRING | SUMMER 1 | SUMMER 2 |  |  | EECE2140 |  |  |  |  | 4
 | NOTES: | NOTES: | NOTES: | NOTES: SUBMIT UPDATED PLAN TO ADVISOR FOR CLEARANCE REVIEW. |  |  | EECE2150 |  |  |  |  | 5
YEAR 3 | CO-OP | EECExxxx EE/CE Fund 4/5cr | ENGW3302 Adv. Writ.: Tech Prof 4cr | CO-OP | YEAR 3 |  | EECE2160 |  |  |  |  | 4
 |  | EECExxxx EE/CE Fund 4/5cr | or 3315 Interdisciplinary Adv. Writ. |  |  |  | Required: 3 EE Fundamentals
 |  | EECExxxx EE/CE Fund 4/5cr | XXXX____ Gen Elective 2 4cr |  |  |  | EECE2412 |  |  |  |  | 4
 |  | EECExxxx EE/CE Fund 4/5cr |  |  |  |  | EECE2413 lab |  |  |  |  | 1
 |  |  |  |  |  |  | EECE2520 |  |  |  |  | 4
 |  |  |  |  |  |  | EECE2530 |  |  |  |  | 4
 |  |  |  |  |  |  | EECE2531 lab |  |  |  |  | 1
 |  |  |  |  |  |  | Required: 3 CE Fundamentals
 | FALL | SPRING | SUMMER 1 | SUMMER 2 |  |  | EECE2322 |  |  |  |  | 4
 | NOTES: | NOTES: | NOTES: | NOTES: |  |  | EECE2323 lab |  |  |  |  | 1
YEAR 4 | CO-OP | EECExxxx EE/CE Fund 4/5cr | EECE4791 Capstone 1 1cr | CO-OP | YEAR 4 |  | EECE2540 |  |  |  |  | 4
 |  | EECExxxx EECE Tech Elective 1 4cr | EECExxxx EECE Tech Elective 3 4cr |  |  |  | EECE2560 |  |  |  |  | 4
 |  | EECExxxx EECE Tech Elective 2 4cr |  |  |  |  | CAPSTONE
 |  | EECE3468 Noise & Stoch. Pro. 4cr |  |  |  |  | EECE4791 |  |  |  |  | 1
 |  | ENCP3000 Prof. Issues 1cr |  |  |  |  | EECE4792 |  |  |  |  | 4
 |  |  |  |  |  |  | TECH. ELECT.
 |  |  |  |  |  |  | EECExxxx |  |  |  |  | 4
 |  |  |  |  |  |  | EECExxxx |  |  |  |  | 4
 | FALL | SPRING | SUMMER 1 | SUMMER 2 |  |  | EECExxxx |  |  |  |  | 4
 | NOTES: | NOTES: | NOTES: | NOTES: |  |  | EECExxxx |  |  |  |  | 4
YEAR 5 | CO-OP | EECE4792 Capstone 2 4cr |  |  | YEAR 5 |  | ADD'L ENG.
 |  | EECExxxx EECE Tech Elective 4 4cr |  |  |  |  | GE 1501 > |  |  |  |  | 3
 |  | XXXX____ Gen Elective 3 4cr |  |  |  |  | GE 1502 > |  |  |  | 1 | 3
 |  | XXXX____ Gen Elective 4 4cr |  |  |  |  | EECE3468 |  |  |  | 2 | 2
 |  |  |  |  |  |  | PROF. DVLPMT. |  | GRADE | TOTAL CREDITS
 |  |  |  |  |  |  | GE 1000 >
 | ADVISING NOTES |  |  |  |  |  | EECE2000 >
 |  |  |  |  |  |  | EECE3000 >
# | <-- Click to view degree requirements in the catalog, including elective options not specified. |  |  |  |  |  | SUPP. COURSES |  | GRADE | TOTAL CREDITS
 | > The following NU Path requirements to be completed with General Electives: Interpreting Culture (IC), Difference & Diversity (DD) and Societies & Institutions (SI).
 | > Always plan to register for at least 16 credits in a semester (+ required labs/recitations). |  |  |  |  |  | ENGW1111 >
 | > Students with less than 12 billing credits remaining in their curriculum in their final semester are eligible to submit a petition to reduce load |  |  |  |  |  | ENGW3302 >
 | via the StudentHub--> Academics, Classes, and Registration --> Registrar Forms. Submit the petition after registering for final degree requirements. |  |  |  |  |  | or 3315
 | > Keep semester loads balanced. For instance, try to evenly distribute general electives, writing courses and non-engineering coursework.
 | > Course availability as listed is subject to change depending on departmental offerings. Students should always check the projected course offerings
 | as well as the semester schedule prior to registration. |  |  |  |  |  | GENERAL ELECTIVES | X' the box for each NU Path requirement when it is complete. | GRADE | TOTAL CREDITS | IC | DD | SI
 | > This sheet is a planning tool, but is not meant to substitute for the degree audit and catalog. It is the student's responsibility to check their degree audit to ensure
 | that degree requirements are being met. |  |  |  |  |  | XXXX____ >
 | >A minimum cumulative GPA requirement of 2.000 in major coursework and a minimum cumulative GPA requirement of 2.000 overall are required for graduation. |  |  |  |  |  | XXXX____ >
 | Requirements Specific to Combined Electrical & Computer Engr. Majors |  |  |  |  |  | XXXX____ >
 |  |  |  |  |  |  | XXXX____ >
 | 1. The Capstone Design Courses are taken as follows: (EECE4791 - Summer 1 and EECE4792 - Spring) OR (EECE4791 - Summer 2 and EECE4792 - Fall)
 | 2. For engineering majors, ENGW3315 is an acceptable substitution for ENGW3302.
 | 3. NUpath requirements, Interpreting Culture (IC), Societies and Institutions (SI) and Differences and Diversity (DD) are not explicitly satisfied by required
 | engineering courses. Students are responsible for satisfying these requirements, and if these are not fulfilled in engineering courses, should use General
 | Electives to do so. General Electives are academic, non-remedial, non-repetitive courses. Should you choose not to pursue a co-op experience, you are
 | required to satisfy the Integration Experience (EX) NUpath requirement through other coursework.
 | 4. Total Required General Elective Credits: 16 |  |  |  |  |  | MATH/SCIENCE CREDITS |  | MINIMUM |  |  | 30
 | 5. Three (3) Required CE Fundamentals: |  |  |  |  |  |  |  | EARNED |  |  | 0
 | EECE2322/2323 - Fundamentals Digital Design & Lab AND EECE2540 - Fundamentals Networks AND EECE2560 - Fundamentals Algorithms |  |  |  |  |  | ENGINEERING CREDITS |  | REQUIRED |  |  | 68
 | 6. Three (3) Required EE Fundamentals: |  |  |  |  |  |  |  | EARNED |  |  | 0
 | EECE2412/2413 - Fundamentals Electronics 1 & lab AND EECE2520 - Fundamentals Linear Systems AND EECE 2530/2531 - Fundamentals Electromagnetics & lab. |  |  |  |  |  | TOTAL CREDITS |  | REQUIRED |  |  | 135
 | 7. Technical Elective Requirements: 2 EECE Technical Electives and 2 Khoury College of Computer Sciences (CS) Technical Electives: |  |  |  |  |  |  |  | EARNED |  |  | 0
 | 2 EECE courses from the following approved list:
 | EECE2750, EECE3154, (EECE3324-EECE3410), ( EECE4512-EECE4698), (EECE4991-EECE4993), (EECE5155-EECE5698), GE4608, ENGR5670 |  |  |  |  |  | AP/IB CREDITS
 | 2 CS/CY/IS courses from the following approved list: |  |  |  |  |  | STUDENTS ARE ALLOWED TO COUNT A MAXIMUM OF 32 CREDITS FROM AP/IB COURSES TOWARD TOTAL CREDIT REQUIREMENT. ANY CREDITS OVER THE LIMIT MUST BE MADE UP WITH ADDITIONAL GENERAL ELECTIVE COURSEWORK.
 | CY2550, (CS3200-CS3500), (CS3540-CS3800), (CS4100-CY4770), CS4850, (IS4200- IS4700) |  |  |  |  |  |  |  | EARNED |  |  | 0
 | 8. The registrar’s website provides a listing of degree requirements and the DARS system provides a degree audit utility for students. |  |  |  |  |  |  |  | ALLOWED |  |  | 32
 |  |  |  |  |  |  |  |  | DIFFERENCE
 | Notes: |  | Minor (optional):
 |  |  | Minor Advisor/Email:
 |  |  | REQUIRED COURSES COMPLETED
 | REMOTE CAPSTONE DESIGN POLICY
 |  | The capstone design course is a team effort, and students should try their best to be on-campus working with their team members. Capstone consists of two courses, Capstone 1 (EECE 4790) and Capstone 2 (EECE 4792). Capstone 1 is offered during summer, and it is divided into two sections. Students in the summer 1 section will continue capstone 2 in the spring of the following year and students in the summer 2 section will continue capstone 2 in the fall of the same year. We allow students to take capstone 1 remotely with valid reasoning. However, all students must be on-campus for capstone 2. During the first week of summer 1 or summer 2, we will have an assembly meeting, in which teams are created and advisors are associated with them. Each team consisting of 5 or 6 students is required to meet with the assigned advisor every week for one hour. The advisor usually has five teams and meets with each team at a mutually agreeable time once a week. Note that students will not meet at the designated scheduled classes every day after the first week. However, it is expected that each team arranges more meetings per week (at school or remotely) to be actively involved with the project.
 |  | The following rules apply for students who are taking capstone remotely:
 |  | 1. The remote student should submit an email to the Capstone Coordinator, Professor Bahram Shafai (shafai@ece.neu.edu), at least one month before the start of the Capstone 1 term explaining the reason for not being available on campus. Most of the cases can be resolved by communications. | 2. The remote student must attend the assembly meeting(s) in person during the first week before committing to any summer internship, job, family visit or travel. | 3. If the remote student is not available at the assembly meeting(s), the student is responsible for finding a capstone team in advance to represent the student at the meeting. | 4. If the remote student cannot find a complete team, then the student should find one or more students to represent the remote student at the assembly meeting. | 5. The remote student will be placed in a capstone team if this student cannot form a team.
 |  | 6. The remote student should arrange to be available during the weekly meeting with the capstone advisor and have full agreement from the team that this arrangement is acceptable. | 7. The student should identify personal responsibilities for the capstone team. | 8. The remote student must attend the final proposal presentation in person at the end of the summer session. | 9. If the remote student is not available on-campus for final proposal presentation, then the student can remotely present or integrate their presentation with a short video-clip in the PowerPoint slides. | If there are additional questions or concerns, please contact Professor Bahram Shafai by email: shafai@ece.neu.edu or Cell: (617)721-4805.

Sheet: 5 yrs, 3 co-ops (spring cycle)
 | B.S. in Electrical and Computer Engineering |  |  | CURRICULUM PLANNER |  | DEGREE CLEARANCE FORM
 | 5 years, 3 co-ops in Spring/Summer 1 [BB Pattern] |  | > Hover over a course to view prerequisites, frequency, and other advising notes. |  |  | >After pasting completed courses into the Degree Clearance Form, fill in the grade and credits earned.
 | This sheet is a planning tool, but is not meant to substitute for the degree audit and catalog. It is the student's responsibility to check their degree audit to ensure that degree requirements are being met.
 | Please refer to the academic catalog for more detailed information on each course (https://catalog.northeastern.edu/) |  | > Cut and paste course cells if moving to a different semester |  |  | > Transfer credit grades: College = 'T', Advanced Placement = 'AP', International Baccalaureate = 'IB'
 | Name: |  | > Cut and paste course cells into the Degree Clearance Form when completed
 | Student ID: |  |  |  |  | > Be sure to accurately indicate total Northeastern credits awarded for transfer and study abroad courses.
 | Year of Graduation: |  | > Before making any changes, read important advising notes at bottom of document.
 | Capstone: |  |  |  |  | > Input course numbers for all elective coursework
 | FALL | SPRING | SUMMER 1 | SUMMER 2 |  | MATH & SCIENCE |  | GRADE | TOTAL CREDITS | MATH/SCI CREDITS | ENG'G CREDITS
 | NOTES: | NOTES: | NOTES: | NOTES:
YEAR 1 | MATH1341 Calc 1 for Eng. 4cr | MATH1342 Calc 2 for Eng. 4cr |  |  | YEAR 1 | CHEM1151 > |  |  |  | 4
 | CHEM1151 Chem for Eng. 4cr | PHYS1151 Phys 1 for Eng. 3cr |  |  |  | CHEM1153 >
 | CHEM1153 Recitation | PHYS1152 Phys 1 lab 1cr |  |  |  | CS1800 > |  |  |  | 4
 | GE 1000 First-Year Seminar 1cr | PHYS1153 Physics ILS 1cr |  |  |  | CS1802 > |  |  |  | 1
 | GE 1501 Cornerstone 1 4cr | GE 1502 Cornerstone 2 4cr |  |  |  | MATH1341 > |  |  |  | 4
 | ENGW1111 1st Year Writ. 4cr | XXXX____ Gen Elective 1 4cr |  |  |  | MATH1342 > |  |  |  | 4
 |  |  |  |  |  | MATH2321 > |  |  |  | 4
 |  |  |  |  |  | MATH2341 > |  |  |  | 4
 | FALL | SPRING | SUMMER 1 | SUMMER 2 |  | PHYS1151 > |  |  |  | 3
 | NOTES: | NOTES: | NOTES: | NOTES: |  | PHYS1152 > |  |  |  | 1
YEAR 2 | MATH2341 Diff Eq/Lin. Alg. 4cr | CO-OP | CO-OP |  | YEAR 2 | PHYS1153 > |  |  |  | 1
 | PHYS1155 Phys 2 for Eng. 3cr |  |  |  |  | PHYS1155 > |  |  |  | 3
 | PHYS1156 Phys 2 lab 1cr |  |  |  |  | PHYS1156 > |  |  |  | 1
 | PHYS1157 Physics 2 ILS 1cr |  |  |  |  | PHYS1157 > |  |  |  | 1
 | EECE2150 Circuits & Signals 5cr OR EECE2160 Embedded Design 4cr
 | EECE2140 Computing Fundamentals for Engineers 4cr
 | ENCP2000 Intro. To Co-op 1cr |  |  |  |  | ENGI- NEERING |  | GRADE | TOTAL CREDITS | MATH/SCI CREDITS | ENG'G CREDITS
 | FALL | SPRING | SUMMER 1 | SUMMER 2 |  | EECE2140 |  |  |  |  | 4
 | NOTES: | NOTES: | NOTES: | NOTES: SUBMIT UPDATED PLAN TO ADVISOR FOR CLEARANCE REVIEW. |  | EECE2150 |  |  |  |  | 5
YEAR 3 | CS1800 Discrete Structures 4cr | CO-OP | CO-OP | XXXX____ Gen Elective 2 4cr | YEAR 3 | EECE2160 |  |  |  |  | 4
 | CS1802 Recitation 1cr |  |  | ENGW3302 Adv. Writ.: Tech Prof 4cr |  | Required: 3 EE Fundamentals
 | MATH2321 Calc 3 for Eng. 4cr |  |  | or 3315 Interdisciplinary Adv. Writ. |  | EECE2412 |  |  |  |  | 4
 | EECE2150 Circuits & Signals 5cr OR EECE2160 Embedded Design 4cr |  |  |  |  | EECE2413 lab |  |  |  |  | 1
 | EECExxxx EE/CE Fund. 4/5cr |  |  |  |  | EECE2520 |  |  |  |  | 4
 |  |  |  |  |  | EECE2530 |  |  |  |  | 4
 |  |  |  |  |  | EECE2531 lab |  |  |  |  | 1
 |  |  |  |  |  | Required: 3 CE Fundamentals
 | FALL | SPRING | SUMMER 1 | SUMMER 2 |  | EECE2322 |  |  |  |  | 4
 | NOTES: | NOTES: | NOTES: | NOTES: |  | EECE2323 lab |  |  |  |  | 1
YEAR 4 | EECExxxx EE/CE Fund 4/5cr | CO-OP | CO-OP | EECExxxx Technical Elective 1 4cr | YEAR 4 | EECE2540 |  |  |  |  | 4
 | EECExxxx EE/CE Fund 4/5cr |  |  | EECE4791 Capstone 1 1cr |  | EECE2560 |  |  |  |  | 4
 | EECExxxx EE/CE Fund 4/5cr |  |  |  |  | CAPSTONE
 | EECExxxx EE/CE Fund 4/5cr |  |  |  |  | EECE4791 |  |  |  |  | 1
 | ENCP3000 Prof. Issues 1cr |  |  |  |  | EECE4792 |  |  |  |  | 4
 |  |  |  |  |  | TECH. ELECT.
 |  |  |  |  |  | EECExxxx |  |  |  |  | 4
 |  |  |  |  |  | EECExxxx |  |  |  |  | 4
 | FALL | SPRING | SUMMER 1 | SUMMER 2 |  | EECExxxx |  |  |  |  | 4
 | NOTES: | NOTES: | NOTES: | NOTES: |  | EECExxxx |  |  |  |  | 4
YEAR 5 | EECE4792 Capstone 2 4cr | EECExxxx EECE Tech Elective 3 4cr |  |  | YEAR 5 | ADD'L ENG.
 | EECExxxx EE/CE Fund 4/5cr | EECExxxx EECE Tech Elective 4 4cr |  |  |  | GE 1501 > |  |  |  |  | 3
 | EECExxxx EECE Tech Elective 2 4cr | XXXX____ Gen Elective 4 4cr |  |  |  | GE 1502 > |  |  |  | 1 | 3
 | EECE3468 Noise & Stoch. Pro. 4cr | XXXX____ Gen Elective 3 4cr |  |  |  | EECE3468 |  |  |  | 2 | 2
 |  |  |  |  |  | PROF. DVLPMT. |  | GRADE | TOTAL CREDITS
 |  |  |  |  |  | GE 1000 >
 | ADVISING NOTES |  |  |  |  | EECE2000 >
 |  |  |  |  |  | EECE3000 >
# | <-- Click to view degree requirements in the catalog, including elective options not specified. |  |  |  |  | SUPP. COURSES |  | GRADE | TOTAL CREDITS
 | > The following NU Path requirements to be completed with General Electives: Interpreting Culture (IC), Difference & Diversity (DD) and Societies & Institutions (SI).
 | > Always plan to register for at least 16 credits in a semester (+ required labs/recitations). |  |  |  |  | ENGW1111 >
 | > Students with less than 12 billing credits remaining in their curriculum in their final semester are eligible to submit a petition to reduce load |  |  |  |  | ENGW3302 >
 | via the StudentHub--> Academics, Classes, and Registration --> Registrar Forms. Submit the petition after registering for final degree requirements. |  |  |  |  | or 3315
 | > Keep semester loads balanced. For instance, try to evenly distribute general electives, writing courses and non-engineering coursework.
 | > Course availability as listed is subject to change depending on departmental offerings. Students should always check the projected course offerings
 | as well as the semester schedule prior to registration. |  |  |  |  | GENERAL ELECTIVES | X' the box for each NU Path requirement when it is complete. | GRADE | TOTAL CREDITS | IC | DD | SI
 | > This sheet is a planning tool, but is not meant to substitute for the degree audit and catalog. It is the student's responsibility to check their degree audit to ensure
 | that degree requirements are being met. |  |  |  |  | XXXX____ >
 | >A minimum cumulative GPA requirement of 2.000 in major coursework and a minimum cumulative GPA requirement of 2.000 overall are required for graduation. |  |  |  |  | XXXX____ >
 | Requirements Specific to Combined Electrical & Computer Engr. Majors |  |  |  |  | XXXX____ >
 |  |  |  |  |  | XXXX____ >
 | 1. The Capstone Design Courses are taken as follows: (EECE4791 - Summer 1 and EECE4792 - Spring) OR (EECE4791 - Summer 2 and EECE4792 - Fall)
 | 2. For engineering majors, ENGW3315 is an acceptable substitution for ENGW3302.
 | 3. NUpath requirements, Interpreting Culture (IC), Societies and Institutions (SI) and Differences and Diversity (DD) are not explicitly satisfied by required
 | engineering courses. Students are responsible for satisfying these requirements, and if these are not fulfilled in engineering courses, should use General
 | Electives to do so. General Electives are academic, non-remedial, non-repetitive courses. Should you choose not to pursue a co-op experience, you are
 | required to satisfy the Integration Experience (EX) NUpath requirement through other coursework.
 | 4. Total Required General Elective Credits: 16 |  |  |  |  | MATH/SCIENCE CREDITS |  | MINIMUM |  |  | 30
 | 5. Three (3) Required CE Fundamentals: |  |  |  |  |  |  | EARNED |  |  | 0
 | EECE2322/2323 - Fundamentals Digital Design & Lab AND EECE2540 - Fundamentals Networks AND EECE2560 - Fundamentals Algorithms |  |  |  |  | ENGINEERING CREDITS |  | REQUIRED |  |  | 68
 | 6. Three (3) Required EE Fundamentals: |  |  |  |  |  |  | EARNED |  |  | 0
 | EECE2412/2413 - Fundamentals Electronics 1 & lab AND EECE2520 - Fundamentals Linear Systems AND EECE 2530/2531 - Fundamentals Electromagnetics & lab. |  |  |  |  | TOTAL CREDITS |  | REQUIRED |  |  | 135
 | 7. Technical Elective Requirements: 2 EECE Technical Electives and 2 Khoury College of Computer Sciences (CS) Technical Electives: |  |  |  |  |  |  | EARNED |  |  | 0
 | 2 EECE courses from the following approved list:
 | EECE2750, EECE3154, (EECE3324-EECE3410), ( EECE4512-EECE4698), (EECE4991-EECE4993), (EECE5155-EECE5698), GE4608, ENGR5670 |  |  |  |  | AP/IB CREDITS
 | 2 CS courses from the following approved list: |  |  |  |  | STUDENTS ARE ALLOWED TO COUNT A MAXIMUM OF 32 CREDITS FROM AP/IB COURSES TOWARD TOTAL CREDIT REQUIREMENT. ANY CREDITS OVER THE LIMIT MUST BE MADE UP WITH ADDITIONAL GENERAL ELECTIVE COURSEWORK.
 | CY2550, (CS3200-CS3500), (CS3540-CS3800), (CS4100-CY4770), CS4850, (IS4200- IS4700) |  |  |  |  |  |  | EARNED |  |  | 0
 | 8. The registrar’s website provides a listing of degree requirements and the DARS system provides a degree audit utility for students. |  |  |  |  |  |  | ALLOWED |  |  | 32
 |  |  |  |  |  |  |  | DIFFERENCE
 | Notes: |  | Minor (optional):
 |  |  | Minor Advisor/Email:
 |  |  | REQUIRED COURSES COMPLETED
 | REMOTE CAPSTONE DESIGN POLICY
 | The capstone design course is a team effort, and students should try their best to be on-campus working with their team members. Capstone consists of two courses, Capstone 1 (EECE 4790) and Capstone 2 (EECE 4792). Capstone 1 is offered during summer, and it is divided into two sections. Students in the summer 1 section will continue capstone 2 in the spring of the following year and students in the summer 2 section will continue capstone 2 in the fall of the same year. We allow students to take capstone 1 remotely with valid reasoning. However, all students must be on-campus for capstone 2. During the first week of summer 1 or summer 2, we will have an assembly meeting, in which teams are created and advisors are associated with them. Each team consisting of 5 or 6 students is required to meet with the assigned advisor every week for one hour. The advisor usually has five teams and meets with each team at a mutually agreeable time once a week. Note that students will not meet at the designated scheduled classes every day after the first week. However, it is expected that each team arranges more meetings per week (at school or remotely) to be actively involved with the project.
 | The following rules apply for students who are taking capstone remotely:
 | 1. The remote student should submit an email to the Capstone Coordinator, Professor Bahram Shafai (shafai@ece.neu.edu), at least one month before the start of the Capstone 1 term explaining the reason for not being available on campus. Most of the cases can be resolved by communications. | 2. The remote student must attend the assembly meeting(s) in person during the first week before committing to any summer internship, job, family visit or travel. | 3. If the remote student is not available at the assembly meeting(s), the student is responsible for finding a capstone team in advance to represent the student at the meeting. | 4. If the remote student cannot find a complete team, then the student should find one or more students to represent the remote student at the assembly meeting. | 5. The remote student will be placed in a capstone team if this student cannot form a team.
 | 6. The remote student should arrange to be available during the weekly meeting with the capstone advisor and have full agreement from the team that this arrangement is acceptable. | 7. The student should identify personal responsibilities for the capstone team. | 8. The remote student must attend the final proposal presentation in person at the end of the summer session. | 9. If the remote student is not available on-campus for final proposal presentation, then the student can remotely present or integrate their presentation with a short video-clip in the PowerPoint slides. | If there are additional questions or concerns, please contact Professor Bahram Shafai by email: shafai@ece.neu.edu or Cell: (617)721-4805.

Sheet: Technical Elective Options
EEPH Technical Elective Course Options (COE)
Course offerings vary each semester, especially during the summer (summer offerings are limited), so double check which of these offerings are available in the semester you decide to take your tech electives
EECE students must complete two of the following courses to fulfill the EECE tech elective requirement.
EECE 2750 | Enabling Engineering
Any course from EECE 3324 to EECE 3410
Any course from EECE 4512 to EECE 4698
EECE 4991 (Research)
EECE 4992 (Directed Study)
EECE 4993 (Independent Study)
Any course from EECE 5115 to EECE 5698
ENGR 5670 | Sustainable Energy: Materials, Conversion, Storage, and Usage
Two CS/CY/IS courses from the following approved list may be taken towards the EECE tech elective requirement
CS 3200 | Database Design
CS 3500 | Object-Oriented Design
Any course from CS 3450 to CS 3800
Any course from CS 4100 to CS 4770
CS 4850 | Building Game Engines
CY 2550 | Foundations of Cybersecurity
Any course from IS 4200 to IS 4700

Sheet: General Elective Exclusions
COE General Elective Course Exclusions
CS 1100
ENGW1101
ENGW1110
ENGW3300
ESL
FSEM1103
FSEM1104
GENS1101
MATH0000 through MATH1299
MATH1343
MATH1990
EXSC****
PHYS1121
PHYS1141
PHYS1145
PHYS1147
PHYS1149
PHYS1150
*Students who took GE1501 and GE1502 cannot take GE1110 or GE1111 as general electives, and vice versa. The content of these courses is repetitive. |  | l elective or technical elective and vice versa as the content is repetitive.
MATH3081 | The following majors cannot count MATH3081 as a general elective: CompE/CompSci, CompE/Physics, CompE, CivE, CivE/Arch Studies, EnvE, EnvE/Landscape Architecture, EnvE/Health Science, Industrial Engineering
