IbrahimAyoub05/AIglasses/PCB/yg/GBR_11290166_1_bottom.png

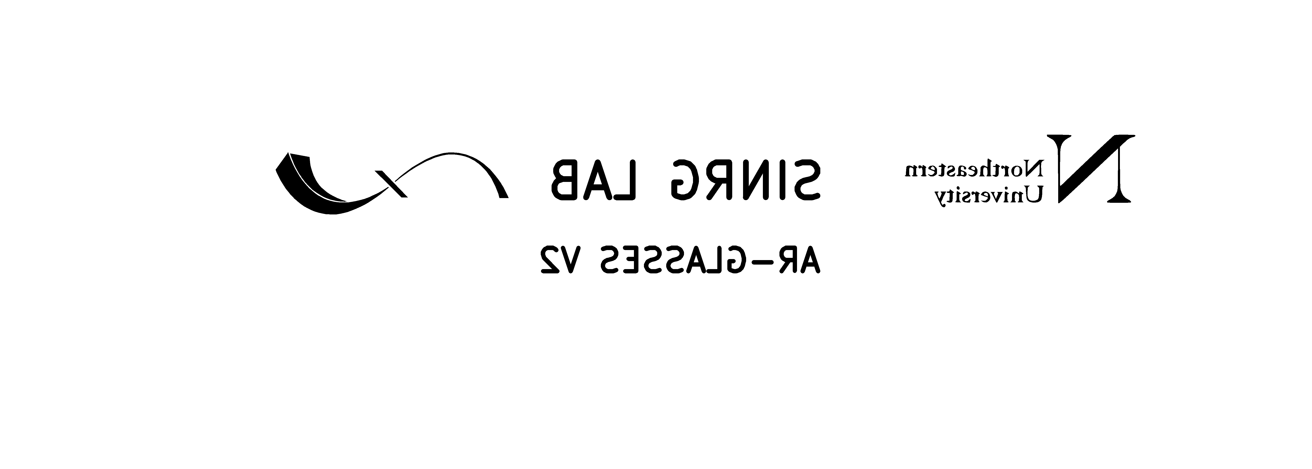
PCB/yg/GBR_11290166_1_bottom.png
