IbrahimAyoub05/AIglasses/PCB/yg/GBR_11290166_1_top.png

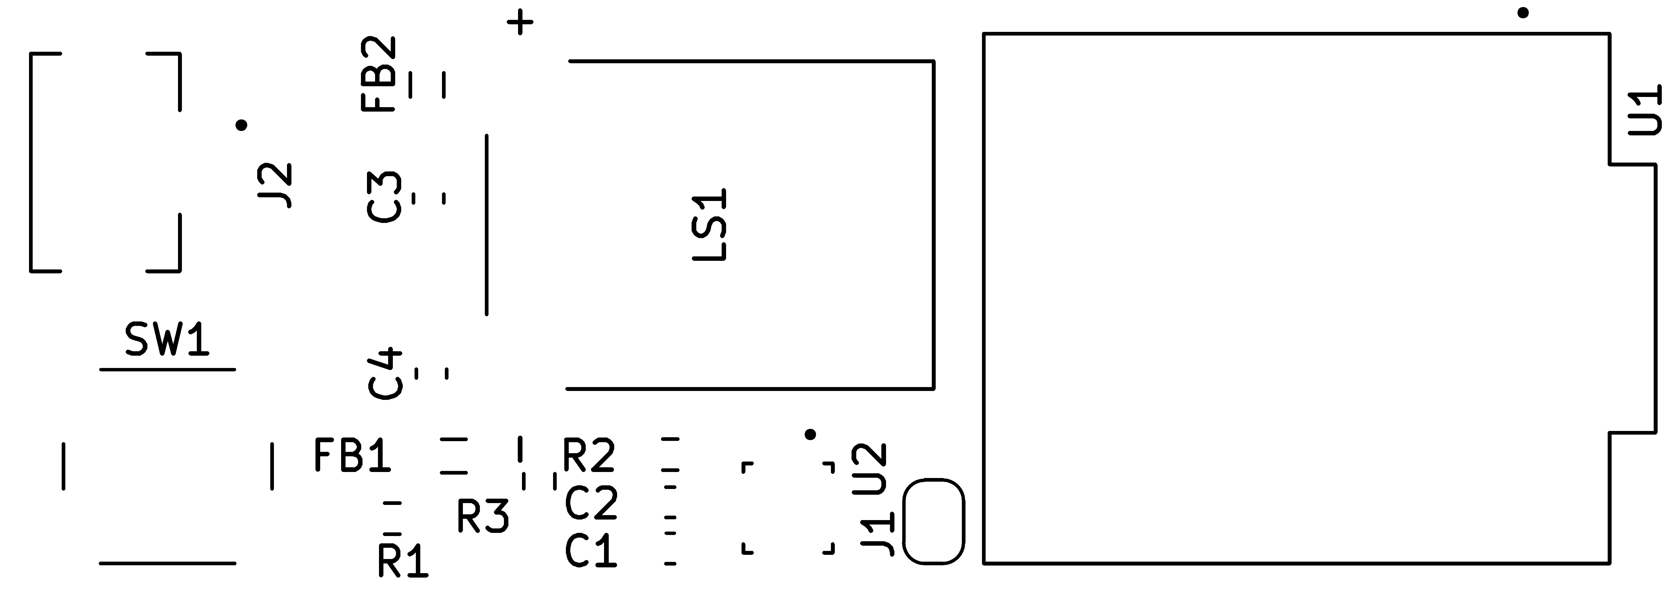
PCB/yg/GBR_11290166_1_top.png
