IbrahimAyoub05/AIglasses/Cad Designs/V3/STL/ThreadedRod.stl

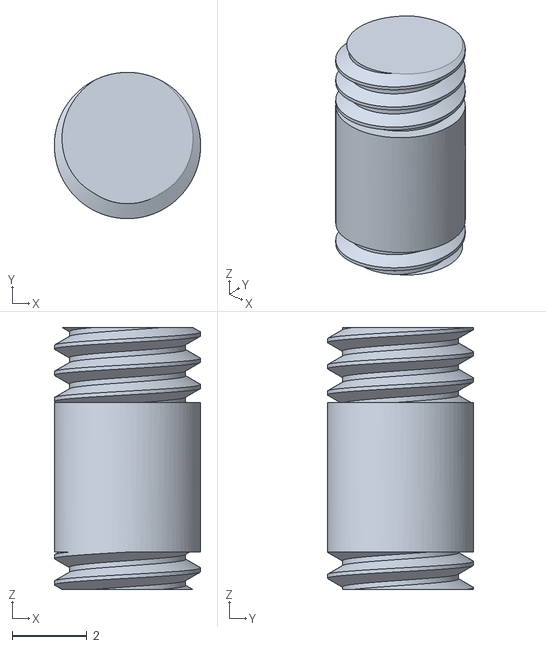
[picture p30: CAD file, 2026-06-15]
Cad Designs/V3/STL/ThreadedRod.stl
3.91 x 3.91 x 7.00
