IbrahimAyoub05/AIglasses/Cad Designs/V3/STL/HInge.stl

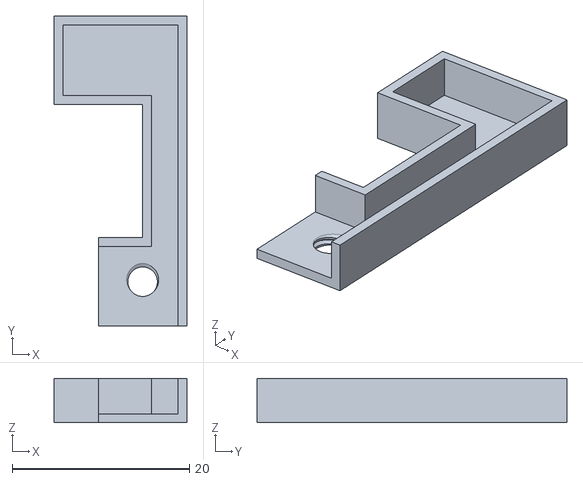
[picture p31: CAD file, 2026-06-15]
Cad Designs/V3/STL/HInge.stl
15.0 x 35.0 x 5.00
