IbrahimAyoub05/AIglasses/Cad Designs/V3/STL/Rod v6.stl

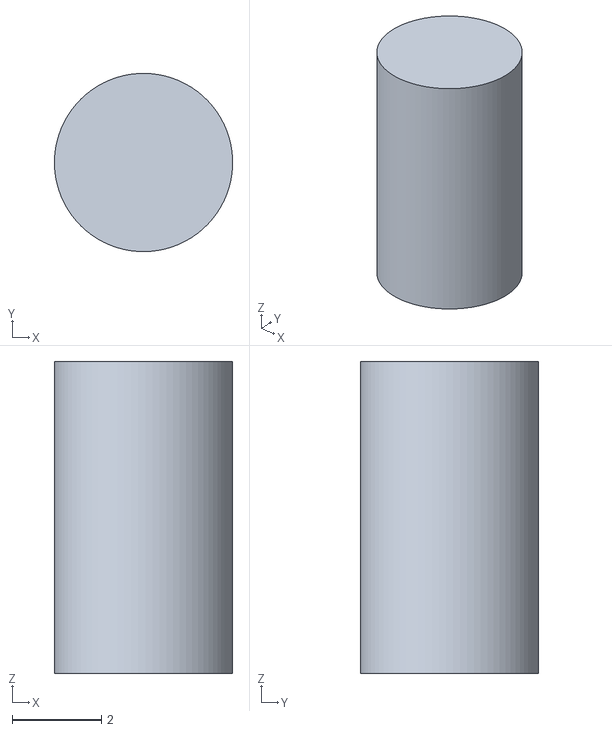
[picture p32: CAD file, 2026-06-15]
Cad Designs/V3/STL/Rod v6.stl
4.00 x 4.00 x 7.00
