IbrahimAyoub05/AIglasses/Cad Designs/V3/STL/ArmCover.stl

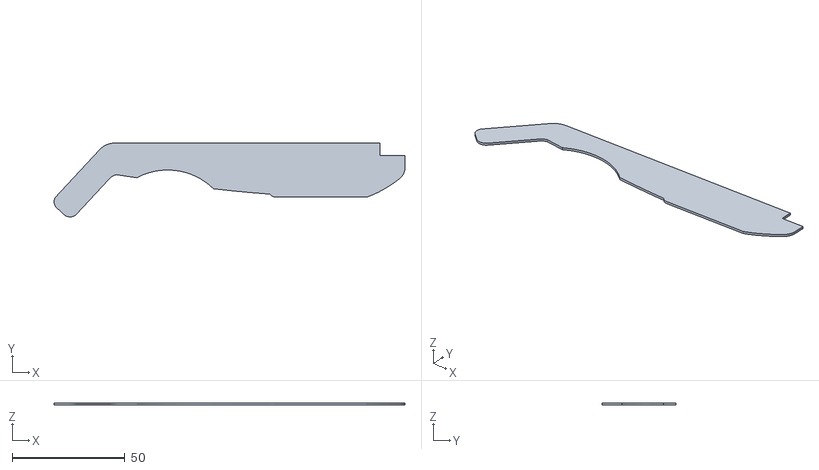
[picture p33: CAD file, 2026-06-15]
Cad Designs/V3/STL/ArmCover.stl
155.8 x 32.8 x 1.00
