IbrahimAyoub05/AIglasses/Cad Designs/V3/STL/HIngeTop v2.stl

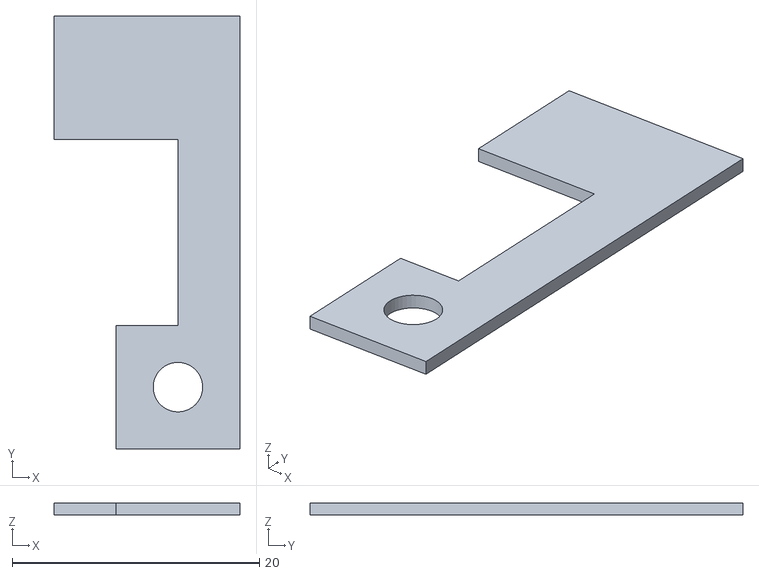
[picture p34: CAD file, 2026-06-15]
Cad Designs/V3/STL/HIngeTop v2.stl
15.0 x 35.0 x 1.00
