IbrahimAyoub05/AIglasses/Cad Designs/V3/STL/RightArm.stl

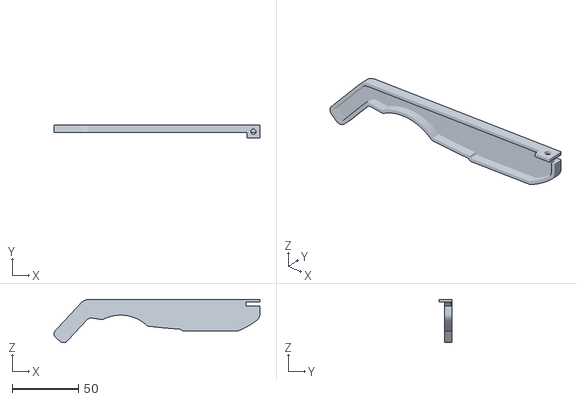
[picture p36: CAD file, 2026-06-15]
Cad Designs/V3/STL/RightArm.stl
155.8 x 10.2 x 32.8
