IbrahimAyoub05/AIglasses/Cad Designs/V3/STL/Nut.stl

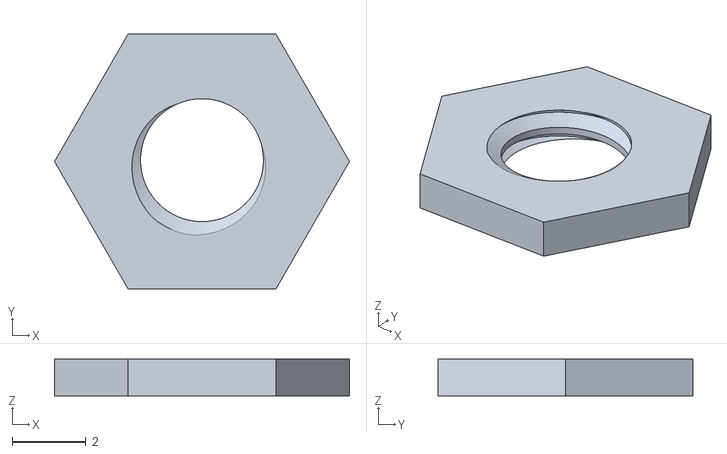
[picture p37: CAD file, 2026-06-15]
Cad Designs/V3/STL/Nut.stl
8.00 x 6.93 x 1.00
