IbrahimAyoub05/AIglasses/Cad Designs/Older/Glasses 3D Design 1/Frame1.stl

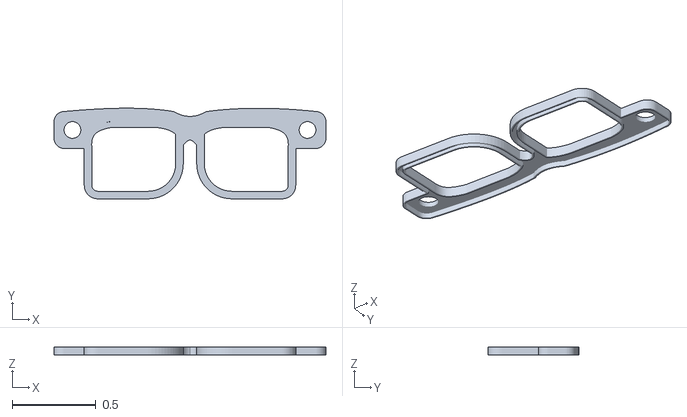
[picture p38: CAD file, 2026-06-15, an earlier design]
Cad Designs/Older/Glasses 3D Design 1/Frame1.stl
1.62 x 0.54 x 0.05
