IbrahimAyoub05/AIglasses/Cad Designs/Older/Glasses 3d Design 2/Front.stl

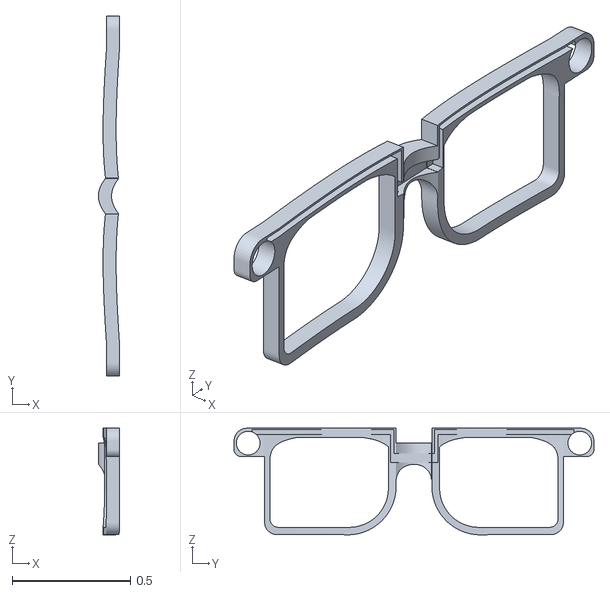
[picture p39: CAD file, 2026-06-15, an earlier design]
Cad Designs/Older/Glasses 3d Design 2/Front.stl
0.0899 x 1.52 x 0.45
