IbrahimAyoub05/AIglasses/Cad Designs/Older/V2/PCB/pcb_right.step

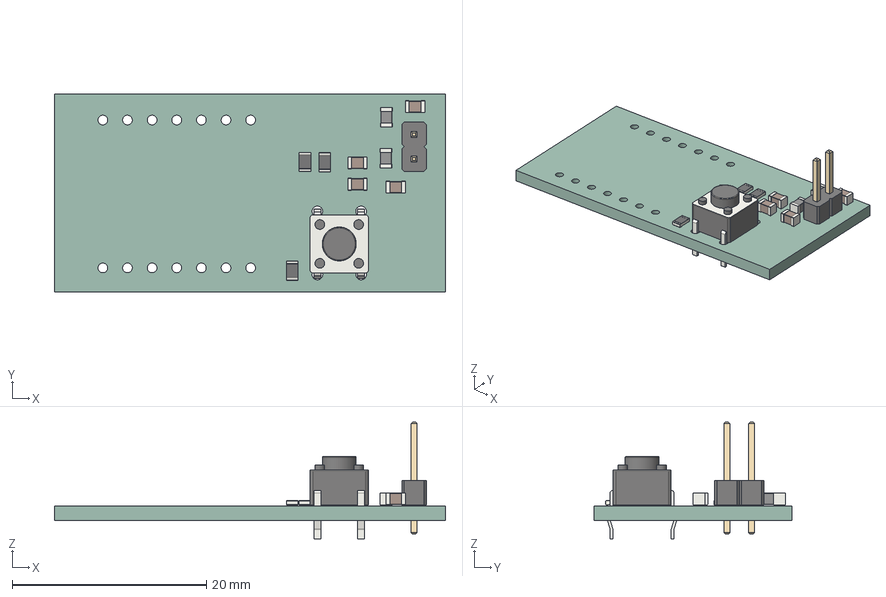
[picture p41: CAD file, 2026-06-15, an earlier design]
Cad Designs/Older/V2/PCB/pcb_right.step
40.3 x 20.4 x 12.0 mm
C_0805_2012Metric x 4
L_0805_2012Metric x 2
R_0805_2012Metric x 3
SW_PUSH_6mm_H5mm
PinHeader_1x02_P2.54mm_Vertical
pcb_right_PCB
