IbrahimAyoub05/AIglasses/Cad Designs/Older/V2/STL/Body1.stl

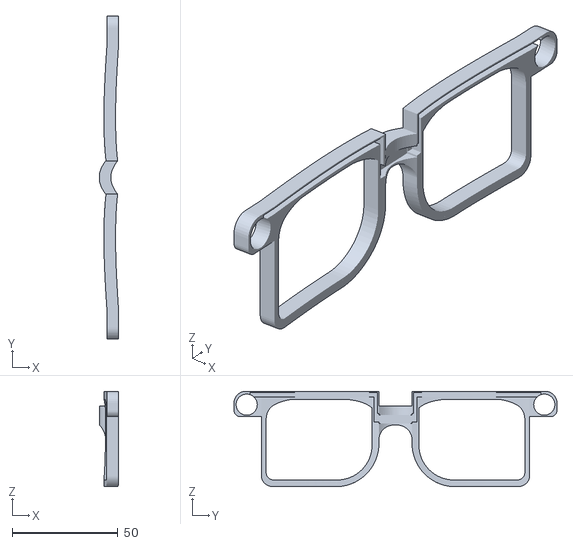
[picture p42: CAD file, 2026-06-15, an earlier design]
Cad Designs/Older/V2/STL/Body1.stl
9.16 x 152.4 x 45.0
