IbrahimAyoub05/AIglasses/Cad Designs/Older/Glasses 3D Design 1/arm2.stl

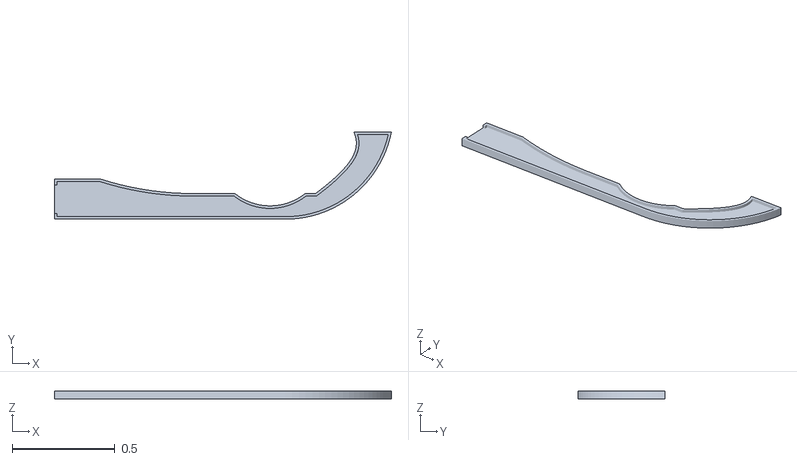
[picture p43: CAD file, 2026-06-15, an earlier design]
Cad Designs/Older/Glasses 3D Design 1/arm2.stl
1.64 x 0.425 x 0.04
