IbrahimAyoub05/AIglasses/Cad Designs/Older/Glasses 3d Design 2/ArmRight2.stl

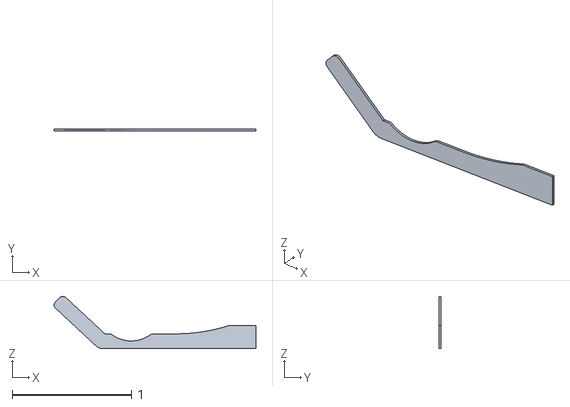
[picture p44: CAD file, 2026-06-15, an earlier design]
Cad Designs/Older/Glasses 3d Design 2/ArmRight2.stl
1.70 x 0.015 x 0.44
