IbrahimAyoub05/AIglasses/Cad Designs/Older/V1/ArmCovers_CoverLeft v1.3mf

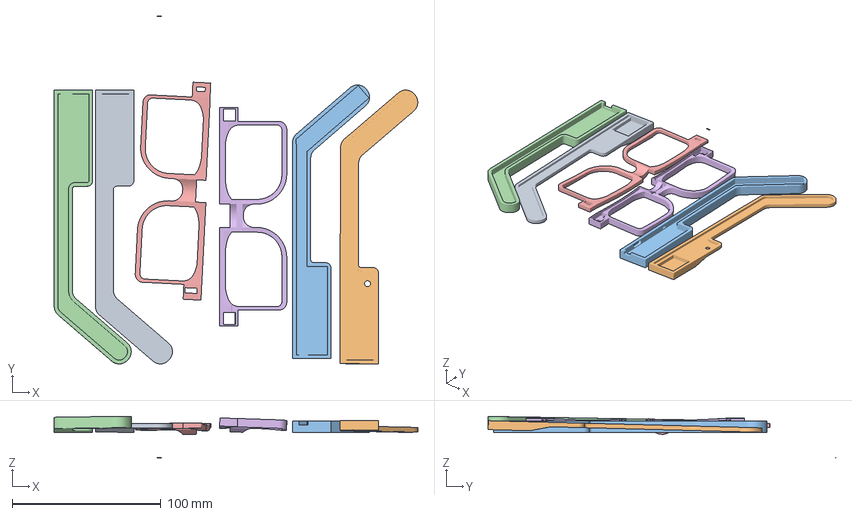
[picture p45: CAD file, 2026-06-15, an earlier design]
Cad Designs/Older/V1/ArmCovers_CoverLeft v1.3mf
244.2 x 233.7 x 27.6 mm
ArmCovers_CoverLeft v1.stl
ArmCovers_CoverRight v1.stl
LeftArm v1.stl
RightArm v1.stl
FrameCover v1.stl
FrontFrames v2.stl
