IbrahimAyoub05/AIglasses/(list of files, cad)

Other CAD files:
Cad Designs/Older/Glasses 3D Design 1/Arm1.stl
Cad Designs/Older/Glasses 3d Design 2/ArmLeft1.stl
Cad Designs/Older/Glasses 3d Design 2/ArmLeft2.stl
Cad Designs/Older/Glasses 3d Design 2/ArmRight1.stl
Cad Designs/Older/Glasses 3d Design 2/Front2.stl
Cad Designs/Older/Glasses 3d Design 2/Glasses.3mf
Cad Designs/Older/V1/ArmCovers_CoverLeft v1.stl
Cad Designs/Older/V1/ArmCovers_CoverRight v1.3mf
Cad Designs/Older/V1/ArmCovers_CoverRight v1.stl
Cad Designs/Older/V1/Component3.f3d
Cad Designs/Older/V1/FrameCover v1.stl
Cad Designs/Older/V1/FrameCover.f3d
Cad Designs/Older/V1/FrontFrames v2.stl
Cad Designs/Older/V1/LeftArm v1.stl
Cad Designs/Older/V2/STL/FrameCover.stl
Cad Designs/Older/V2/STL/RightArm Cover v4.stl
Cad Designs/Older/V2/STL/RightArm.stl
