IbrahimAyoub05/AIglasses/Docs/Older Documentation/PLATFORMIO_SETUP_COMPLETE.md

# ✅ PlatformIO Setup Complete!

I've successfully converted your Arduino IDE projects to PlatformIO! Here's what was created:

## 📁 Project Structure

### C6_App_imp (BLE Version)
```
C6_App_imp/
├── platformio.ini          # PlatformIO configuration
├── src/
│   └── main.cpp           # Your BLE voice assistant code
├── C6_App_imp.ino         # Original Arduino file (kept for reference)
└── README.md              # Project-specific guide
```

### C6Imp (WebSocket Version)
```
C6Imp/
├── platformio.ini          # PlatformIO configuration
├── src/
│   └── main.cpp           # Your WebSocket voice assistant code
├── C6_imp/
│   └── C6_imp.ino        # Original Arduino file (kept for reference)
└── README.md              # Project-specific guide
```

## 🚀 Quick Start

### Option 1: Using VS Code (Recommended)

1. **Install PlatformIO Extension**
   - Open VS Code
   - Go to Extensions (Cmd+Shift+X)
   - Search for "PlatformIO IDE"
   - Click Install

2. **Open a Project**
   - File → Open Folder
   - Choose either `C6_App_imp` or `C6Imp` folder

3. **Build & Upload**
   - Click the PlatformIO icon in the sidebar
   - Under "PROJECT TASKS" → "esp32-c6-devkitc-1"
   - Click "Upload" to build and flash
   - Click "Monitor" to view serial output

### Option 2: Using Command Line

```bash
# Navigate to project directory
cd "C6_App_imp"  # or "C6Imp"

# Build the project
pio run

# Upload to ESP32-C6
pio run --target upload

# Monitor serial output
pio device monitor

# Or do all at once
pio run --target upload && pio device monitor
```

## 🔧 Configuration Details

### ESP32-C6 Support
Both projects are configured with:
- **Platform**: Espressif32 v6.8.1+
- **Arduino Framework**: v3.0.7 (ESP32-C6 compatible)
- **Board**: esp32-c6-devkitc-1
- **USB CDC**: Enabled (for serial communication over USB)
- **Upload Speed**: 921600 baud
- **Monitor Speed**: 115200 baud

### Libraries Installed Automatically
- **C6_App_imp**: NimBLE-Arduino v1.4.1+
- **C6Imp**: WebSockets v2.4.1+

## 📝 Before You Start

### For C6Imp (WebSocket Version) ONLY:
Edit `C6Imp/src/main.cpp` and update your WiFi credentials:
```cpp
const char* WIFI_SSID = "YourNetworkName";    // Line 6
const char* WIFI_PASS = "YourPassword";        // Line 7
const char* WS_HOST = "your-server.domain";    // Line 10
```

### For C6_App_imp (BLE Version):
No configuration needed! Just upload and use the Android app.

## 🎯 Key Advantages of PlatformIO

1. **Automatic Library Management** - Dependencies are downloaded automatically
2. **Better Build System** - Faster incremental builds
3. **Professional IDE** - Superior code completion and debugging
4. **Multi-Environment Support** - Easy to manage different configurations
5. **CLI Support** - Can build/upload from terminal
6. **Version Control Friendly** - Cleaner project structure

## 🐛 Troubleshooting

### Can't find ESP32-C6 board
The configuration uses Arduino-ESP32 v3.0.7 which includes ESP32-C6 support. First build will download all necessary packages.

### Upload fails
```bash
# List available ports
pio device list

# Specify port manually (example)
pio run --target upload --upload-port /dev/cu.usbserial-*
```

### Library not found
```bash
# Clean and rebuild
pio run --target clean
pio run
```

### Serial monitor shows garbled text
Make sure you're using the USB port (not UART). The ESP32-C6 uses USB CDC for serial communication.

## 📚 Additional Resources

- **PLATFORMIO_GUIDE.md** - Detailed guide for using PlatformIO
- **C6_App_imp/README.md** - BLE project documentation
- **C6Imp/README.md** - WebSocket project documentation
- [PlatformIO Documentation](https://docs.platformio.org/)
- [ESP32-C6 Arduino Core](https://github.com/espressif/arduino-esp32)

## 🎉 Next Steps

1. **Choose your project**
   - Use C6_App_imp for BLE (works with Android app)
   - Use C6Imp for WebSocket (needs WiFi server)

2. **Open in VS Code**
   - Install PlatformIO extension
   - Open project folder
   - Click Upload button

3. **Test it!**
   - Monitor serial output
   - Check pin connections match your hardware
   - Press PTT button (GPIO23) to test

## ⚡ Pro Tips

- Use `pio run --target upload --upload-port <PORT>` to specify exact port
- Use `pio device monitor -f esp32_exception_decoder` for better error messages
- Keep both .ino and .cpp files if you need to switch between Arduino IDE and PlatformIO
- Add `.pio/` and `.vscode/` to `.gitignore` if not already there

---

**Status**: ✅ Both projects are ready to build and upload!

**Hardware**: ESP32-C6-DevKitC-1 with INMP441 mic + MAX98357A amp

**Tested**: Configuration verified for ESP32-C6 Arduino framework v3.0.7
