IbrahimAyoub05/AIglasses/Preformance Tests/C6/C6_App_imp_Session4_Results.docx

C6_App_imp

Performance Metrics Report

ESP32-C6 BLE Voice Assistant — Full-Stack Instrumentation

Firmware (Arduino / NimBLE) + Android (Kotlin / BLE GATT)

STATIC / DESIGN | Value known from source code / configuration
CAPTURED AT RUNTIME | Value emitted by the instrumented log statements — search logcat / Serial Monitor for the tag shown

Branch: perf-instrumentation | Date: 2026-03-12

# Table of Contents

# 1. Overview

This report documents full-stack performance instrumentation applied to the C6_App_imp project (ESP32-C6 BLE Voice Assistant). Timing and performance log statements were inserted into all four source files listed below. The code changes live exclusively on the perf-instrumentation branch and have not been merged to main.

Instrumented files:

- C6_App_imp/C6_App_imp.ino — ESP32-C6 Arduino firmware (NimBLE + I2S)
- AIglasses/…/BleVoiceService.kt — Android BLE GATT client
- AIglasses/…/VoiceAssistantPipeline.kt — Android processing pipeline
- AIglasses/…/OpenAIService.kt — Whisper / GPT / TTS API calls

All 15 metrics requested are covered. Static values are derived from source code analysis. Runtime values are emitted by the instrumented log statements — see the log-tag column in each section.

Sessions 4–5 Hardware Capture Summary — XIAO_ESP32C6

Metric | Measured Value | Notes
SESSION 4 (ESP32 Serial, 2026-03-12)
M4 — BLE TX Duration | 10,574 ms | ESP32 side: first byte → last byte
M5 — Buffer Usage | 163,760 B (99.95%) | ⚠ 81,880 samples; nearly full!
M5 — Audio Content | 3.71 s | 81,880 samples ÷ 22,050 Hz
M7 — Total Round-Trip | 16,512 ms (16.51 s) | PTT release → speaker output
M8 — I2S SPK→MIC Switch | 51 ms | [PERF-M8] after playback end
M10 — BLE RX Throughput | 15,815 B/s (15.4 KB/s) | 35.9% of 44.1 KB/s requirement
M12 — Dead Time | 51 ms | Playback end → mic ready
M13 — Free Heap (post-play) | 183,664 B (179.4 KB) | min_ever = 124,496 B
SESSION 5 (Android logcat + ESP32, 2026-03-13)
M1 — Whisper Latency | 2,526 ms | OpenAI Whisper API (HTTP round-trip)
M2 — GPT Latency | 1,933 ms | GPT-4o-mini API response
M3 — TTS API | 2,722 ms | tts-1 API (HTTP); MP3 decode: 566 ms
M3 — Pipeline Total | 7,754 ms (7.75 s) | Whisper + GPT + TTS + MP3 decode
M4 — BLE TX (Android) | 5,572 ms | 168 packets × 84,672 bytes
M9 — Negotiated MTU | 512 bytes | 507 bytes audio payload/packet
M10 — BLE TX Throughput | 15,195 B/s (14 KB/s) | Android TX side
M11 — Utterance Duration | 2.52–2.62 s | 80,736–83,968 bytes (ESP32/Android)
M13 — Heap on-connect | 184,808 B (180.5 KB) | Session 5 BLE connect
M13 — Heap ptt-released | 182,904 B (178.6 KB) | min_ever = 178,764 B

# 2. How the Data Was Collected

Session 4 — ESP32 Serial Monitor (2026-03-12):

- The instrumented firmware (branch perf-instrumentation) was flashed to the XIAO_ESP32C6.
- The Serial Monitor was opened at 115200 baud in Arduino IDE while a full query cycle was performed: PTT held to record a voice utterance, released to transmit, and the TTS response played back through the MAX98357A speaker.
- All [PERF-Mxx] tagged lines were copied directly from the Serial Monitor output. This session populated M4, M5, M7, M8 (SPK→MIC), M10 (ESP32 RX throughput), M12, and M13 (after-playback).

Session 5 — Android logcat + ESP32 Serial Monitor (2026-03-12):

- The AIGlasses app (branch perf-instrumentation) was built and installed on an Android device via Android Studio.
- Two terminals were run in parallel: one capturing ESP32 serial output, and one running adb logcat filtered to the instrumented tags:
  - adb logcat -s BleVoiceService:V VoiceAssistantPipeline:V OpenAIService:V
- A full query cycle was completed (PTT → BLE TX → OpenAI pipeline → TTS → BLE RX → playback). Both outputs were captured simultaneously.
- This session populated M1, M2, M3, M9, M10 (Android TX), M11, M13 (on-connect / ptt-pressed / ptt-released), and confirmed M15.

Session 6 — ESP32 Boot Log (2026-03-13):

- The ESP32-C6 was restarted with the Serial Monitor already open at 115200 baud to capture the boot sequence before any BLE connection.
- This captured the three M13 RAM checkpoints (after-boot, after-mic-init, after-ble-init) and the M8 MIC→SPK switch time of 1 ms logged during i2sMicInit().

Every log line is prefixed with its metric ID (e.g., [PERF-M6], [PERF-M13]) allowing direct grep or logcat filtering by metric number. M16 (Power) was not captured at runtime — it was derived from the ESP32-C6, INMP441, and MAX98357A datasheets combined with firmware analysis.

# 3. Performance Metrics

M1 Utterance Processing Time CAPTURED AT RUNTIME

CAPTURED AT RUNTIME

Metric | Value | Notes / Meaning
Stage: Whisper API | ~ 600-1500 ms | Network RTT to api.openai.com + whisper-1 inference
Stage: GPT API | ~ 300-800 ms | gpt-4o-mini latency (short prompts)
Stage: TTS API | ~ 400-900 ms | tts-1 synthesis network time
Stage: MP3 decode | ~ 50-150 ms | Android MediaCodec decode + resample
TOTAL pipeline | ~ 1.5-3.5 s | Sum of above; end-to-end before BLE TX starts

Log tags to search:

[PERF-M1] Whisper total time: 2526 ms (OpenAIService.kt)

[PERF-M2] GPT total time: 1933 ms (OpenAIService.kt)

[PERF-M3] TTS API time: 2561 ms (OpenAIService.kt)

[PERF-M1] TOTAL pipeline: 7754 ms (VoiceAssistantPipeline.kt)

! | SESSION 5 RESULT: Whisper=2,528 ms | GPT=1,934 ms | TTS=2,722 ms | MP3 decode=566 ms | TOTAL=7,754 ms (7.75 s). Pipeline exceeded the 3.5 s estimate — mostly due to TTS latency. Consider streaming TTS (chunked HTTP) to start BLE TX before full MP3 is received.

M2 OpenAI API Response Time CAPTURED AT RUNTIME

CAPTURED AT RUNTIME

Metric | Value | Notes / Meaning
Whisper (transcription) | 2,526 ms | Session 5 — [PERF-M1] Whisper total time
GPT chat completion | 1,933 ms | Session 5 — [PERF-M2] GPT total time
HTTP timeout settings | connect: 30 s | OkHttpClient config in OpenAIService companion
| read: 60 s
| write: 30 s

Log tags to search:

[PERF-M1] Whisper request start / response received (OpenAIService.kt)

[PERF-M2] GPT request start / response received (OpenAIService.kt)

[PERF-M3] TTS request start / response received (OpenAIService.kt)

! | Each call is independently timed from System.currentTimeMillis() surrounding execute(). If latency exceeds 3 s consistently, evaluate the tts-1-hd model or a local TTS alternative.

M3 Text-to-Speech Conversion Time CAPTURED AT RUNTIME

CAPTURED AT RUNTIME

Metric | Value | Notes / Meaning
TTS API (network) | 2,722 ms | Session 5 — [PERF-M3] TTS API done (including HTTP overhead)
MP3 decode (device) | 566 ms | Session 5 — [PERF-M3] MP3 decode via Android MediaCodec
Resample (if needed) | included | Windowed-sinc resampler (src rate != 22050 Hz)
TTS output format | MP3, voice=nova | Returned as raw MP3 bytes from tts-1 endpoint
Final PCM format | 22050 Hz mono 16-bit | After decode + resample in decodeMp3ToPcm()

Log tags to search:

[PERF-M3] TTS API time: 2561 ms (OpenAIService.kt)

[PERF-M3] MP3 decode: 566 ms (VoiceAssistantPipeline.kt)

[PERF-M3] TTS total (API+decode): 3288 ms

[PERF-M3] TTS PCM ready: 84672 bytes (1.92 s)

M4 Audio Transmission Time (Android -> ESP32) CAPTURED AT RUNTIME

CAPTURED AT RUNTIME

Metric | Value | Notes / Meaning
TX start | measured | System.currentTimeMillis() before first BLE write
TX end | measured | After last ACK + end-marker ACK
TX duration (Android) | 5,572 ms | Session 5 — [PERF-M4] Android TX complete time
TX duration (ESP32) | 10,574 ms | Session 4 — [PERF-M4] first byte → last byte on ESP32
Total bytes (Android) | 84,672 B | Session 5 — 168 BLE audio packets sent from Android
Total bytes received | 167,226 B | Session 4 — 160 BLE audio packets received on ESP32
Per-packet wait | up to 200 ms | waitForWriteAck() spin-loop per audio packet (WRITE_WITH_RESPONSE)

Log tags to search:

[PERF-M4] Audio TX start — 84672 bytes max_payload: 507 bytes/packet (BleVoiceService.kt) ← Sess.5

[PERF-M4] Audio TX complete — 168 packets 84672 bytes 5572 ms (BleVoiceService.kt) ← Sess.5

[PERF-M4] Audio TX start — 167226 bytes max_payload: 507 bytes/packet (BleVoiceService.kt) ← Sess.4

[PERF-M4] Audio TX complete — 160 packets 167226 bytes 10574 ms (BleVoiceService.kt) ← Sess.4

! | SESSION 4 RESULT: 167,226 bytes transmitted in 10,574 ms. WRITE_WITH_RESPONSE paces each packet to the ESP32 receive rate. With MTU 512 and ~507 bytes/packet, 160 packets were needed. Throughput was ~15.8 KB/s — see M10 for real-time requirement analysis.

M5 Audio Buffer Capacity STATIC / DESIGN

STATIC / DESIGN

Metric | Value | Notes / Meaning
Buffer size (bytes) | 163,840 B | MAX_AUDIO_BUFFER = 160 * 1024 (C6_App_imp.ino)
Buffer size (KB) | 160 KB | Static allocation, always reserved in DRAM
Max audio @ 22050 Hz | 3.71 s | 163840 / (22050 * 2) = 3.714 s of 16-bit mono
Current session usage | 163,760 B (99.95%) | Session 4 — 81,880 samples × 2 = 163,760 B ⚠ nearly full!
Audio content | 3.71 s | Session 4 — 81,880 samples ÷ 22,050 Hz = 3.713 s
Playback chunks | 160 chunks | Session 4 — 160 × ~1024 B chunks played back
Overflow handling | drop fragment | "BUFFER FULL" printed; fragment discarded silently

Log tags to search:

[PERF-M5] Buffer: 163760 / 163840 bytes (99.95%) = 3.71 s of audio (C6_App_imp.ino)

[PERF-M5] Final buffer: 163760 bytes (3.71 s) capacity: 163840 bytes (3.71 s max)

[PERF-M5] OVERFLOW: attempted to exceed 163840 byte capacity (if triggered)

! | ⚠ SESSION 4 WARNING: Buffer was 99.95% full (163,760 / 163,840 B). This TTS response nearly exhausted the entire 160 KB buffer. Any response longer than 3.71 s would overflow and be truncated. Increase MAX_AUDIO_BUFFER to 256 KB or implement streaming playback.

M6 ESP32 Playback Start Delay CAPTURED AT RUNTIME

CAPTURED AT RUNTIME

Metric | Value | Notes / Meaning
End marker received | measured | endMarkerTime_ms set in ControlCallbacks.onWrite()
i2sSpkInit() time | measured | [PERF-M8] I2S->SPK switch time (included in delay)
enableAmp() + delay | ~50 ms | Fixed delay() after i2sSpkInit before first i2s_write
Total start delay | measured | [PERF-M6] = playbackStartTime_ms - endMarkerTime_ms

Log tags to search:

[PERF-M6] Playback start delay (end_marker -> first_i2s_write): XXX ms (C6_App_imp.ino)

[PERF-M8] I2S -> SPK switch time: XX ms (included in the above) (C6_App_imp.ino)

! | Expected ~70-120 ms (50 ms amp settle + I2S reinit). If this grows above 200 ms investigate I2S driver install time — the uninstall + reinstall cycle on the shared bus is the main contributor.

M7 Total Round-Trip Latency CAPTURED AT RUNTIME

CAPTURED AT RUNTIME

Metric | Value | Notes / Meaning
PTT release | t = 0 | pttReleaseTime_ms set in loop() on wasPressed -> false
Whisper | + 2,528 ms | Session 5 — network + inference — see M1
GPT | + 1,934 ms | Session 5 — network round-trip — see M2
TTS API | + 2,722 ms | Session 5 — network round-trip — see M3
MP3 decode | + 566 ms | Session 5 — Android CPU — see M3
BLE TX to ESP32 | + 10,574 ms | Session 4 WRITE_WITH_RESPONSE; 167,226 B at 15.4 KB/s
ESP32 playback start | + measured | I2S reinit + amp settle — see M6 (not yet captured)
TOTAL estimate | ~ 5-6 seconds | Typical Wi-Fi; higher on cellular
TOTAL measured | 16,512 ms (16.51 s) | Session 4 — [PERF-M7] PTT_release → speaker_out

Log tags to search:

[PERF-M7] Total round-trip latency (PTT_release -> speaker_out): 16512 ms (16.51 s) (C6_App_imp.ino)

! | SESSION 4 RESULT: 16.51 s end-to-end — significantly above the 5-6 s estimate. The BLE TX alone took 10,574 ms (64% of total latency) transferring 167,226 B at only 15.4 KB/s. Switching to WRITE_WITHOUT_RESPONSE would be the single highest-impact optimization.

M8 I2S Mode Switching Time (Mic <-> Speaker) CAPTURED AT RUNTIME

CAPTURED AT RUNTIME

Metric | Value | Notes / Meaning
MIC -> SPK (in play) | 1 ms | Session 6 boot — [PERF-M8] I2S -> MIC switch time
SPK -> MIC (after play) | 51 ms | Session 4 — [PERF-M8] I2S → MIC switch time
i2s_driver_uninstall | ~20-50 ms | Blocking call; frees DMA descriptors
i2s_driver_install | ~10-30 ms | Allocates DMA, configures clocks
fixed delay (MIC) | 50 ms | delay(50) after uninstall in i2sMicInit()
fixed delay (SPK) | 20 ms | delay(20) after uninstall in i2sSpkInit()

Log tags to search:

[PERF-M8] I2S -> SPK switch time: XX ms (C6_App_imp.ino)

[PERF-M8] I2S -> MIC switch time: 51 ms (C6_App_imp.ino) ← Session 4

! | SESSION 4 RESULT (SPK→MIC): 51 ms — within expected range (50 ms fixed delay + ~1 ms driver). MIC→SPK switch not captured in this session. ESP32-C6 has a single I2S peripheral so mic and speaker share the bus. The 50 ms mic settle delay is conservative — could be reduced to 20 ms.

M9 BLE MTU Size Negotiated at Connection CAPTURED AT RUNTIME

CAPTURED AT RUNTIME

Metric | Value | Notes / Meaning
Requested MTU | 512 bytes | BLE_MTU constant; TARGET_MTU in Android BleVoiceService
Actual negotiated MTU | 512 bytes | Session 5 — confirmed by both Android + ESP32 logs
ATT overhead | 3 bytes/packet | BLE ATT protocol overhead subtracted from MTU
Header overhead | 2 bytes/packet | TAG(1) + SEQ(1) per audio fragment
Max audio payload | MTU - 5 bytes | Effective audio bytes per BLE packet
@ MTU=512 | 507 bytes/pkt | 512 - 3 - 2 = 507 bytes of audio per packet

Log tags to search:

[PERF-M9] BLE MTU negotiated: 512 bytes (audio payload/packet: 507 bytes) (C6_App_imp.ino)

[PERF-M9] MTU negotiated: 512 bytes (audio payload/packet: 507 bytes) (BleVoiceService.kt)

! | Android 10+ typically supports MTU 517 (Pixel/Samsung). Some older devices cap at 247 or 185. A lower MTU directly increases packet count and total transmission time. Check the negotiated value on first connect and compare to TARGET_MTU=512.

M10 BLE Throughput During Audio Transfer CAPTURED AT RUNTIME

CAPTURED AT RUNTIME

Metric | Value | Notes / Meaning
TX throughput (Android) | 15,195 B/s (14 KB/s) | Session 5 — [PERF-M10] 84,672 B ÷ 5,572 ms
RX throughput (ESP32) | 15,815 B/s (15.4 KB/s) | Session 4 — [PERF-M10]; 167,226 B ÷ 10,574 ms
Total RX bytes | 167,226 B | Session 4 — 160 packets received on ESP32
Theoretical max @ MTU512 | ~33 KB/s | 507 bytes × 65 pkts/s (WRITE_WITH_RESPONSE @ 15 ms CI)
Practical estimate | ~20-28 KB/s | Overhead, ACK latency, stack scheduling
Audio requirement | 44,100 B/s | 22050 Hz × 16-bit mono — above BLE max!
Coverage ratio | 35.9% ⚠ | 15.4 KB/s ÷ 44.1 KB/s — BLE is 2.8× too slow for real-time

Log tags to search:

[PERF-M10] BLE TX throughput: 15195 bytes/s (14 KB/s) MTU: 512 (BleVoiceService.kt)

[PERF-M10] BLE RX throughput: 15815 bytes/s (15.4 KB/s) total: 167226 bytes (C6_App_imp.ino)

! | SESSION 4 RESULT: 15,815 bytes/s (15.4 KB/s) — only 35.9% of the 44,100 bytes/s required for real-time 22 kHz audio. BLE TX took 2.85× the audio content duration (10.57 s TX vs 3.71 s audio). The buffer-then-play architecture is MANDATORY. WRITE_WITHOUT_RESPONSE could raise throughput to ~80 KB/s, eliminating this bottleneck.

M11 Min and Max Utterance Length CAPTURED AT RUNTIME

CAPTURED AT RUNTIME

Metric | Value | Notes / Meaning
Min utterance (time) | 2,523 ms (2.52 s) | Session 5 — [PERF-M11] ESP32 ptt-release time
Max utterance (time) | 2,523 ms (2.52 s) | Session 5 — single utterance; run more sessions for range
Min utterance (bytes) | 80,736 B | Session 5 — [PERF-M11] ~80,736 bytes (ESP32 estimate)
Max utterance (bytes) | 83,968 B | Session 5 — [PERF-M11] 83,968 bytes received (Android)
Minimum threshold | MIN_AUDIO_BYTES = 32000 | 16000 Hz * 2 bytes * 1 s — shorter ignored
Sample rate (mic) | 16000 Hz | Fixed MIC_SR constant
Bit depth (mic BLE) | 16-bit | After >>16 shift from 32-bit I2S slot

Log tags to search:

[PERF-M11] PTT released — utterance: 2523 ms (2.52 s) ~80736 bytes (C6_App_imp.ino)

[PERF-M11] Session min/max: 2523 ms / 2523 ms (C6_App_imp.ino)

[PERF-M11] Utterance received: 83968 bytes 2.62 s (BleVoiceService.kt)

[PERF-M11] Session utterance range: 83968–83968 bytes (BleVoiceService.kt)

! | The 1-second minimum (32,000 bytes) filters noise. Typical voice queries are 2-5 s. Very long utterances (>10 s = 320 KB) may exceed BLE throughput and cause increased latency.

M12 Dead Time Between Playback and Next Record CAPTURED AT RUNTIME

CAPTURED AT RUNTIME

Metric | Value | Notes / Meaning
Playback end | measured | playbackEndTime_ms = millis() after final i2s_write + delay(100)
Mic ready time | measured | micReadyTime_ms = millis() after i2sMicInit() completes
Dead time | 51 ms | Session 4 — [PERF-M12] Dead time (playback_end → mic_ready)
Expected minimum | ~80-130 ms | i2sMicInit() ~70 ms + delay(50) already in switch function
User experience impact | ~0.1-0.2 s | Very brief — ESP32 cannot hear PTT during this window

Log tags to search:

[PERF-M12] Dead time (playback_end -> mic_ready): 51 ms (C6_App_imp.ino) ← Session 4

! | SESSION 4 RESULT: 51 ms dead time — better than the 80-130 ms estimate. The mic was ready very quickly after playback. Note this is the same 51 ms as the I2S→MIC switch (M8), which is expected since dead time ≈ switch time when measured from the same reference point.

M13 ESP32 RAM Usage at Key Moments CAPTURED AT RUNTIME

CAPTURED AT RUNTIME

Metric | Value | Notes / Meaning
After boot | 230,148 B (224.8 KB) | Session 6 boot — largest_block=200,692 B min_ever=225,068 B
After mic init | 220,740 B (215.6 KB) | Session 6 boot — largest_block=200,692 B min_ever=218,872 B
After BLE init | 187,064 B (182.7 KB) | Session 6 boot — largest_block=172,020 B min_ever=187,064 B
On BLE connect | 184,808 B (180.5 KB) | Session 5 — largest_block=167,924 B min_ever=183,532 B
PTT pressed | 184,640 B (180.3 KB) | Session 5 — largest_block=167,924 B min_ever=183,532 B
PTT released | 182,904 B (178.6 KB) | Session 5 — largest_block=163,828 B min_ever=178,764 B
End marker received | measured | [PERF-M13][RAM] end-marker-received (not in this session log)
Before playback | measured | [PERF-M13][RAM] before-playback (not in this session log)
After playback | 183,664 B (179.4 KB) | Session 4 — largest_block=163,828 B min_ever=124,496 B
min_ever (session 4) | 124,496 B (121.6 KB) | Lowest free heap seen across entire session
Total DRAM (ESP32-C6) | ~512 KB | ESP32-C6 has 512 KB DRAM; NimBLE uses ~80 KB
audioBuffer[] static | 160 KB | Always reserved (static allocation at link time)

Log tags to search:

[PERF-M13][RAM] after-playback: free=183664 B (179.4 KB) largest_block=163828 B min_ever=124496 B

! | SESSION 4 RESULT: After playback, free heap = 183,664 B (179.4 KB). The largest free block (163,828 B) nearly matches the audioBuffer (163,840 B), suggesting BLE buffers were freed. min_ever = 124,496 B (121.6 KB) — still adequate. Watch for values below 80 KB which would risk allocation failure during concurrent BLE + I2S.

M14 Behavior When PTT Pressed During Playback CAPTURED AT RUNTIME

CAPTURED AT RUNTIME

Metric | Value | Notes / Meaning
Detection | in loop() | Checked on every press: currentI2SMode == MODE_SPEAKER || playAudio
Action taken | log + continue | Warning logged; loop continues — I2S is in SPEAKER mode
Mic availability | UNAVAILABLE | i2sMicInit() has not been called — no audio captured
When mic becomes ready | after playSpeaker() | i2sMicInit() is called at end of playSpeaker()
Data loss | YES | Any speech during playback is NOT captured or transmitted

Log tags to search:

[PERF-M14] PTT pressed DURING playback! (C6_App_imp.ino)

[PERF-M14] I2S mode: SPEAKER playAudio flag: true/false (C6_App_imp.ino)

[PERF-M14] Behavior: press ignored — I2S is in SPEAKER mode, mic unavailable.

! | Current behavior silently discards user speech during playback. A better UX would be to: (1) detect the PTT press, (2) stop I2S TX early, (3) switch to mic mode, and (4) begin a new utterance. This requires interrupt-based PTT detection rather than polling in loop().

M15 Audio Quality Parameters STATIC / DESIGN

STATIC / DESIGN

Metric | Value | Notes / Meaning
Mic sample rate | 16000 Hz | MIC_SR constant; standard telephony bandwidth
Speaker sample rate | 22050 Hz | SPK_SR constant; ~CD quality sufficient for voice
Mic I2S bit depth | 32-bit slot | I2S_BITS_PER_SAMPLE_32BIT; 24-bit audio in upper bits
Mic BLE bit depth | 16-bit | After micBuf32[i] >> 16 — top 16 bits of 32-bit slot
Speaker bit depth | 16-bit | I2S_BITS_PER_SAMPLE_16BIT; adequate for TTS
Mic channel format | ONLY_LEFT mono | INMP441 LR pin tied to GND — outputs on left slot
Speaker channel format | RIGHT_LEFT stereo | Both L and R driven with same mono sample for dual-amp
Mic DMA config | 8 bufs x 256 | 2048-sample ring buffer — 128 ms at 16 kHz
Speaker DMA config | 16 bufs x 1024 | 16384-sample ring buffer — 743 ms at 22050 Hz headroom
Speaker APLL | enabled | use_apll = true — jitter-free I2S clock, reduces distortion
Speaker auto-clear | enabled | tx_desc_auto_clear = true — silence on underrun, not garbage
Mic chunk size | 512 samples | SAMPLES_PER_CHUNK; 32 ms per BLE notify
BLE stereo interleave | 512 mono->1024 stereo | STEREO_CHUNK_MONO=512; L=R for dual MAX98357A
TTS format | MP3, tts-1, nova | Decoded client-side with Android MediaCodec
TTS final PCM | 22050 Hz mono 16-bit | After decodeMp3ToPcm() + optional resample

Log tags to search:

[PERF-M15] AUDIO QUALITY PARAMETERS AT STARTUP: (C6_App_imp.ino Serial output)

[PERF-M15] MP3 format: audio/mpeg 24000 Hz 1 ch (VoiceAssistantPipeline.kt logcat)

[PERF-M15] Resampling 24000 Hz -> 22050 Hz (VoiceAssistantPipeline.kt — confirmed Session 5)

[PERF-M15] Final PCM: 84672 bytes 22050 Hz mono 16-bit

! | Mic and speaker use different sample rates (16 kHz vs 22 kHz). The OpenAI TTS API returns audio at 24 kHz which is then resampled to 22050 Hz by the windowed-sinc resampler — confirm this in the [PERF-M15] Resampling log line. Mismatch in sample rates is the most common source of audio quality issues (chipmunk / slow-motion effect).

M16 Power Consumption Analysis STATIC / DESIGN

STATIC / DESIGN

Metric | Value | Notes / Meaning
ESP32-C6 CPU @ 160 MHz | 85 mA | Always active — no frequency scaling or sleep modes implemented
BLE @ +9 dBm, advertising | ~6 mA avg | 100 ms adv interval, duty-cycled (setPower(ESP_PWR_LVL_P9))
BLE @ +9 dBm, connected idle | ~15 mA avg | Baseline with BLE connection maintained, low traffic
BLE @ +9 dBm, high TX/RX | ~28 mA avg | WRITE_WITH_RESPONSE bursts at MTU 512 — continuous audio transfer
I2S DMA (mic or speaker) | ~4 mA | I2S peripheral + DMA active during recording or playback
INMP441 MEMS mic | 1.4 mA | Always on after boot init — no firmware power gate
MAX98357A (quiescent) | 2.4 mA | No SD pin control in firmware — draws quiescent continuously
MAX98357A (voice playback) | ~35 mA avg | ~100 mW audio output assumed; ~85% class-D efficiency @ 3.3 V
Mode 1: BLE Advertising | 323 mW / 98 mA | No phone connected — CPU + BLE adv + I2S + INMP441 + amp idle
Mode 2: BLE Connected Idle | 356 mW / 108 mA | Waiting for PTT — CPU + BLE conn + I2S + INMP441 + amp idle
Mode 3: PTT Record + BLE TX | 422 mW / 128 mA | CPU + BLE high-TX + I2S DMA + INMP441 + amp idle
Mode 4: BLE RX (recv TTS) | 389 mW / 118 mA | CPU + BLE high-RX + INMP441 + amp idle
Mode 5: Speaker Playback | 465 mW / 141 mA | CPU + BLE idle + I2S DMA + INMP441 + MAX98357A active
Weighted avg (50% idle/active) | ~380 mW / ~115 mA | Estimated typical interactive session
300 mAh LiPo (small glasses) | ~2.6 hours | 300 mAh ÷ 115 mA — minimal wearable form factor
500 mAh LiPo | ~4.3 hours | 500 mAh ÷ 115 mA — standard wearable battery
1000 mAh LiPo | ~8.7 hours | 1000 mAh ÷ 115 mA — with optimizations est. ~13 h
BLE TX power (current) | +9 dBm (maximum) | ESP_PWR_LVL_P9 set in setup() — unnecessary at <1 m glasses range
BLE TX → 0 dBm saving | −8 mA | Reduce to ESP_PWR_LVL_0; adequate RSSI at wearable distance
CPU 80 MHz idle saving | −40 mA | setCpuFrequencyMhz(80) during BLE idle; no impact on BLE/I2S
Light sleep in loop() saving | −15 mA avg | Replace delay(10) with esp_light_sleep_start(); wake on BLE event
MAX98357A SD pin gate saving | −2.4 mA | Drive GPIO → amp SD low when not playing; only 1 µA shutdown draw
Total optimisation potential | ~50–60 mA saved | All four changes combined — extends battery life by ~50%

! | No power management is implemented. CPU runs at 160 MHz continuously, BLE TX is at maximum +9 dBm, and the MAX98357A has no software power gate. Four low-effort firmware changes (BLE power, CPU scaling, modem sleep, amp SD pin) could reduce average draw from ~115 mA to ~55–65 mA — approximately doubling runtime without any hardware changes.

# 4. Bottleneck Analysis & Recommendations

## 4.1 Latency Bottlenecks (by priority)

# | Bottleneck | Est. Cost | Recommendation

1 | BLE audio TX (WRITE_WITH_RESPONSE) | 10,574 ms (64% of total) | Switch to WRITE_WITHOUT_RESPONSE with ring buffer on ESP32 — potential 5-7× speedup
2 | Whisper + GPT + TTS APIs (sequential) | 7,754 ms measured (Sess.5) | Pipeline: stream TTS while decoding, evaluate local Whisper (whisper.cpp)
3 | Audio buffer overflow risk | 163,760 / 163,840 B (99.95%) | Increase MAX_AUDIO_BUFFER to 256 KB or implement streaming playback
4 | I2S mode switch dead time | 51 ms (measured) | Reduce fixed delay(50) in i2sMicInit() to 20 ms if mic quality allows
5 | MP3 decode on Android | 566 ms measured (Sess.5) | Use PCM output from TTS API to skip decode step

## 4.2 RAM Concerns

- Static audioBuffer[160 KB] is always allocated — 31% of available DRAM.
- NimBLE stack requires ~60-90 KB. Total reserved before app logic: ~250-260 KB.
- SESSION 4: After playback free heap = 183,664 B (179.4 KB). min_ever = 124,496 B (121.6 KB) — adequate margin.
- WATCH: largest_block = 163,828 B after playback ≈ audioBuffer size. BLE buffers freed correctly.
- If min_ever drops below 80 KB during a session, reduce MAX_AUDIO_BUFFER from 160 KB to 128 KB (~2.9 s).
- ⚠ SESSION 4 WARNING: Buffer was 99.95% full. Increase to 256 KB or implement streaming to prevent overflow.

## 4.3 Audio Quality Concerns

- OpenAI tts-1 returns 24 kHz audio; it is resampled to 22050 Hz on Android. Verify resampling fires via [PERF-M15].
- INMP441 L/R grounded — uses left channel. Confirm [PERF-M15] shows ONLY_LEFT format; incorrect pin changes this silently.
- Speaker APLL is enabled (good). If buzzing occurs at low volumes, increase DMA buf_len or check I2S clock mismatch.
- Dual-amp requires L=R interleaving — verified in stereoChunk fill loop in playSpeaker().

## 4.4 PTT-During-Playback UX Issue

Currently, pressing PTT during playback is silently ignored (M14). User speech is lost with no feedback. Recommended fix: detect the edge in an ISR or FreeRTOS task, call i2s_stop() on the TX peripheral, then switch to MIC mode. This requires changing the single-threaded polling loop to an event-driven model.

## 4.5 Power Efficiency Concerns

- Average current draw is ~115 mA @ 3.3 V (~380 mW) — giving ~2.6 h on a 300 mAh glasses battery.
- BLE TX power is set to maximum (+9 dBm) via ESP_PWR_LVL_P9. Glasses sit <1 m from phone — 0 dBm is sufficient and saves ~8 mA.
- CPU runs at 160 MHz with no frequency scaling. Dropping to 80 MHz during BLE idle (between queries) saves ~40 mA with no functional impact.
- The main loop() uses delay(10) polling — replacing with esp_light_sleep_start() + BLE wake event saves ~15 mA average.
- MAX98357A amplifier has no SD pin control in firmware. It draws 2.4 mA quiescent during recording and idle. A single GPIO → SD pin toggle eliminates this.
- Combined: all four changes reduce average draw from ~115 mA to ~55–65 mA, roughly doubling battery life to ~5–5.5 h on 300 mAh.

# 5. Log Tag Quick Reference

Use these tags with adb logcat or grep in the ESP32 serial output:

Log Tag | Metric | Source | What It Captures
[PERF-M1] | M1 | VoicePipeline (Android) | Whisper time, total pipeline time
[PERF-M2] | M2 | OpenAIService (Android) | GPT API response time
[PERF-M3] | M3 | OpenAIService (Android) | TTS API time + MP3 decode time
[PERF-M4] | M4 | BleVoiceService + .ino | TX/RX start, end, duration
[PERF-M5] | M5 | C6_App_imp.ino | Buffer usage % and overflow
[PERF-M6] | M6 | C6_App_imp.ino | end-marker to first i2s_write
[PERF-M7] | M7 | C6_App_imp.ino | PTT release to speaker output
[PERF-M8] | M8 | C6_App_imp.ino | I2S MIC<->SPK switch time
[PERF-M9] | M9 | BleVoiceService + .ino | Negotiated MTU bytes
[PERF-M10] | M10 | BleVoiceService + .ino | TX/RX throughput bytes/s
[PERF-M11] | M11 | BleVoiceService + .ino | Utterance min/max length
[PERF-M12] | M12 | C6_App_imp.ino | Playback end to mic ready
[PERF-M13] | M13 | C6_App_imp.ino | Free heap at 9 key moments
[PERF-M14] | M14 | C6_App_imp.ino | PTT-during-playback event
[PERF-M15] | M15 | C6_App_imp.ino + Pipeline | Sample rates, bit depth, config

Session 4–6 measurements captured on XIAO_ESP32C6 (2026-03-12/13). Metrics M4, M5, M7, M8, M10, M12, M13 (all boot + after-playback stages) populated with actual hardware data. M16 (Power) is derived from Espressif ESP32-C6 datasheet, INMP441 datasheet, and MAX98357A datasheet — not runtime capture. Remaining RUNTIME entries (M6, M13 mid-session stages, M14) require further capture sessions.

Confidential — Instrumentation Branch: perf-instrumentation Page 1

C6_App_imp Performance Metrics Report | ESP32-C6 BLE Voice Assistant Generated: 2026-03-12
