IbrahimAyoub05/AIglasses/Preformance Tests/S3/AIglasses-S3-PerfomanceSummary.docx

AI Glasses With ESP32-S3 and App

Performance Summary

Branch: perf-instrumentation-s3 | April 2026

# Context

The S3_App_imp branch runs the same AI glasses voice assistant pipeline as the previously tested C6_App_imp, but on the XIAO ESP32-S3 Sense hardware. Key architectural differences that are expected to improve performance:

- WRITE_NR (no-response) BLE audio TX — eliminates ACK wait per packet, expected 4–8× faster than C6.
- Independent I2S ports: PDM mic (I2S_NUM_0) and speaker (I2S_NUM_1) never share a bus — no mode switching delay.
- PSRAM-backed 160 KB ring buffer for streaming playback — safer than C6’s flat static buffer.
- Camera (OV3660) adds vision mode capability (double-press PTT).

Instrumentation is committed on branch perf-instrumentation-s3. Data will be collected in two capture sessions (ESP32 Serial Monitor + Android logcat). This summary will be updated when runtime data is available.

# Key Expected Improvements vs C6

- BLE TX is no longer the bottleneck (expected).
- C6 used WRITE_WITH_RESPONSE: 10,574 ms for 167 KB (64% of total round-trip).
- S3 uses WRITE_NR with 8 ms inter-packet delay: estimated 2,000–3,000 ms for equivalent payload.
- Expected throughput: 60–120 KB/s vs C6’s 14 KB/s — above the 44.1 KB/s real-time requirement.
- I2S dead time reduced to ~0 ms.
- C6 required 51 ms to switch between mic and speaker on its single shared I2S peripheral.
- S3 has two independent I2S ports — PDM mic runs continuously; no teardown/reinstall.
- Streaming ring buffer eliminates overflow risk from flat buffer.
- C6 filled its 160 KB static buffer to 99.95% in Session 4 — one longer response would overflow.
- S3 ring buffer supports continuous overflow-safe streaming with underrun protection.
- OpenAI pipeline latency unchanged (same Android app).
- Whisper + GPT + TTS accounted for 7,754 ms in C6 Session 5.
- No changes to OpenAIService.kt or pipeline logic — expect similar API latency.
- Camera adds new latency for vision mode only.
- Estimated 50–200 ms for QVGA JPEG capture + 1–3 s for image BLE TX (NOTIFY, 15 ms/packet).
- Voice-only mode is unaffected by camera.

# Key Results

Values below will be populated after hardware capture sessions. C6 reference values are shown for comparison.

Metric | S3 Result | C6 Reference
End-to-End Round-Trip (M7) | ~18,100 ms (est.)* | 16,512 ms (16.5 s)
BLE TX Duration (M4) | 2,591 ms | 10,574 ms
OpenAI Pipeline Total (M1) | 14,663 ms (voice session) | 7,754 ms
BLE Throughput (M10) | 48,700 B/s (48.7 KB/s) | 15,195 B/s (14 KB/s)
BLE MTU Negotiated (M9) | 512 bytes (confirmed) | 512 bytes
Free Heap After BLE Init (M13) | 213,804 B (208 KB) | 187,064 B (182.7 KB)
Min-Ever Heap (M13) | 213,776 B (208 KB)† | 124,496 B (121.6 KB)
Ring Buffer Overflow (M5) | 0 bytes (no overflow) — ring at 15.5% at playback start | 99.95% full (⚠)
I2S Switch (M8) | N/A — independent ports | 51 ms (SPK→MIC)
Streaming Underrun Rate (M19) | 0% (0 underruns observed) | N/A (C6 buffer-all)
Camera Capture Time (M17) | TBD — [PERF-M17] not captured in log | N/A (no camera on C6)
Image BLE TX Time (M18) | 282 ms, ~7.6 KB, 27 KB/s | N/A (no camera on C6)
Avg Current Draw (M16) | TBD — derived | ~115 mA (380 mW)
Battery Life 300 mAh (M16) | TBD | ~2.6 hours

# Remaining Concerns (Common to C6 and S3)

- OpenAI API adds ~7.75 s of latency (measured on C6; same app on S3).
- TTS API (2,722 ms) and Whisper (2,526 ms) are the dominant costs.
- Streaming TTS (chunked HTTP) would allow BLE TX to begin before full MP3 arrives, reducing perceived latency.
- PTT during playback is silently ignored.
- S3 advantage: PDM mic HW is always active. A future improvement could buffer audio during playback and process after.
- Battery life impacted by camera subsystem.
- OV3660 adds ~5 mA idle / ~40 mA active. Recommend PWDN pin gating between captures.
- MAX98357A SD pin gate not implemented — same issue as C6 (+2.4 mA quiescent drain).

AI Glasses — S3_App_imp Performance Summary April 2026
