IbrahimAyoub05/AIglasses/Preformance Tests/S3/S3_App_imp_PerformanceReport.docx

S3_App_imp

Performance Metrics Report

ESP32-S3 BLE Voice + Vision Assistant — Full-Stack Instrumentation

Firmware (Arduino / NimBLE / IDF I2S v2) + Android (Kotlin / BLE GATT)

Branch: perf-instrumentation-s3 | Date: 2026-04-13

# 1. Overview

This report documents full-stack performance instrumentation applied to the S3_App_imp project (ESP32-S3 BLE Voice + Vision Assistant). Timing and performance log statements were inserted into the three source files listed below. The code changes live exclusively on the perf-instrumentation-s3 branch and have not been merged to main.

Instrumented files:

- S3_App_imp/S3_App_imp.ino — ESP32-S3 Arduino firmware (NimBLE + IDF I2S v2 + Camera)
- AIglasses/…/BleVoiceService.kt — Android BLE GATT client
- AIglasses/…/VoiceAssistantPipeline.kt — Android processing pipeline

All 19 metrics are covered. Static values are derived from source code analysis. Runtime values are emitted by the instrumented log statements — see the log-tag column in each section.

Key S3 architectural differences vs C6 (affects several metrics):

- Independent I2S ports: PDM mic on I2S_NUM_0, speaker STD on I2S_NUM_1 — NO mode switching required.
- PSRAM-backed 160 KB ring buffer for streaming playback (vs C6’s static flat buffer).
- WRITE_NR (no-response) BLE audio TX — expect higher throughput than C6’s WRITE_WITH_RESPONSE.
- Camera (OV3660) adds two new metrics: M17 (capture time) and M18 (image BLE TX time).

# 2. How the Data Will Be Collected

Session A — ESP32 Serial Monitor:

- Flash the perf-instrumentation-s3 firmware to XIAO_ESP32S3 Sense.
- Open Serial Monitor at 115200 baud in Arduino IDE.
- Perform a full query cycle: PTT hold → release → TTS playback.
- All [PERF-Mxx] tagged lines will be printed; copy them directly.
- This session targets: M5, M6, M7, M8, M9, M12, M13 (all boot + runtime stages), M15, M17, M18, M19.

Session B — Android logcat + ESP32 Serial Monitor (parallel):

- Build and install the perf-instrumentation-s3 app via Android Studio.
- Run two terminals in parallel; one for ESP32 serial and one for Android logcat:
- adb logcat -s BleVoiceService:V VoiceAssistantPipeline:V OpenAIService:V
- Complete a full query cycle. Both outputs captured simultaneously.
- This session targets: M1, M2, M3, M4, M9, M10, M11, M13 (on-connect), M14 (vision mode).

Every log line is prefixed with its metric ID (e.g., [PERF-M6], [PERF-M13]) allowing direct grep or logcat filtering.

# 3. Performance Metrics

## M1 Utterance Processing Time

CAPTURED AT RUNTIME

Log tags to search:

- [PERF-M1] Whisper total time: XXXX ms (VoiceAssistantPipeline.kt)
- [PERF-M2] GPT total time: XXXX ms (VoiceAssistantPipeline.kt)
- [PERF-M3] TTS API time: XXXX ms (VoiceAssistantPipeline.kt)
- [PERF-M3] MP3 decode: XXXX ms (VoiceAssistantPipeline.kt)
- [PERF-M1] TOTAL pipeline: XXXX ms (VoiceAssistantPipeline.kt)

Metric | Value | Notes / Meaning
Stage: Whisper API | 8,582 ms (voice session) | Network RTT to api.openai.com + whisper-1 inference
Stage: GPT API | 2,417 ms | gpt-4o-mini latency (short prompts)
Stage: TTS API | 2,954 ms | tts-1 synthesis network time
Stage: MP3 decode | 694 ms | Android MediaCodec decode + resample
TOTAL pipeline | 14,663 ms (voice session) | Sum of above; end-to-end before BLE TX starts

⚠ C6 reference (Session 5): Whisper=2,526 ms | GPT=1,933 ms | TTS=2,722 ms | MP3=566 ms | TOTAL=7,754 ms. Same Android app; expect similar values.

## M2 OpenAI API Response Time

CAPTURED AT RUNTIME

Log tags to search:

- [PERF-M1] Whisper total time (VoiceAssistantPipeline.kt)
- [PERF-M2] GPT total time (VoiceAssistantPipeline.kt)
- [PERF-M3] TTS API time (VoiceAssistantPipeline.kt)

Metric | Value | Notes / Meaning
Whisper (transcription) | 8,582 ms | HTTP round-trip including inference
GPT chat completion | 2,417 ms | gpt-4o-mini response
HTTP timeout settings | connect: 30 s / read: 60 s / write: 30 s | OkHttpClient config in OpenAIService

## M3 Text-to-Speech Conversion Time

CAPTURED AT RUNTIME

Log tags to search:

- [PERF-M3] TTS API time: XXXX ms
- [PERF-M3] MP3 decode: XXXX ms
- [PERF-M3] TTS total (API+decode): XXXX ms
- [PERF-M3] TTS PCM ready: XXXXX bytes (X.XX s)

Metric | Value | Notes / Meaning
TTS API (network) | 2,954 ms | HTTP POST to tts-1; includes network + synthesis
MP3 decode (device) | 694 ms | Android MediaCodec decode
TTS output format | MP3, voice=nova | Returned as raw MP3 bytes from tts-1 endpoint
Final PCM format | 22050 Hz mono 16-bit | After decodeMp3ToPcm() + optional resample

## M4 Audio Transmission Time (Android → ESP32)

CAPTURED AT RUNTIME

Log tags to search:

- [PERF-M4] Audio TX start — XXXXX bytes max_payload: XXX bytes/packet WRITE_NR (BleVoiceService.kt)
- [PERF-M4] Audio TX complete — XXX packets XXXXX bytes XXXX ms (BleVoiceService.kt)
- [PERF-M4] Audio RX complete — XXX packets XXXXX bytes XXXX ms (C6_App_imp.ino)

Metric | Value | Notes / Meaning
TX duration (Android) | 2,591 ms (voice session) | System.currentTimeMillis() before first write → after last write
RX duration (ESP32) | ~2,591 ms (est. — WRITE_NR ≈ TX duration) | start-marker → end-marker on ESP32
Total bytes (Android) | ~126,200 bytes (~123 KB) | Full PCM payload sent
Total bytes received | 129,124 bytes (from BLE-RX end-marker log) | Sum of all ring writes on ESP32
Write type | WRITE_NR (no response) | Expected 4–8× faster than C6’s WRITE_WITH_RESPONSE
Inter-packet delay | 8 ms | Thread.sleep(8) per packet in sendAudioToEsp32()

⚠ C6 reference: 10,574 ms for 167,226 B using WRITE_WITH_RESPONSE. S3 uses WRITE_NR with 8 ms delay — expect significantly faster TX.

## M5 Ring Buffer Usage

CAPTURED AT RUNTIME

Log tags to search:

- [PERF-M5] Ring buffer at playback start: XXXXX / 163840 bytes (XX.X%) audio: X.XX s
- [PERF-M5] Final ring buffer: XXXXX bytes received total dropped: X bytes lost_pkts: X

Metric | Value | Notes / Meaning
Ring buffer size | 163,840 B (160 KB) | PSRAM-backed — ps_malloc(RING_SIZE) in setup()
Max audio @ 22050 Hz | 3.71 s | 163840 / (22050 × 2) = 3.714 s of 16-bit mono
Pre-buffer threshold | 24,000 B (~544 ms) | STREAM_START_THRESHOLD before playback starts
Low-water mark | 2,048 B | STREAM_LOW_WATER: inserts silence on underrun below this
Ring fill at start | ~24,000–25,300 B (~14.6–15.5%) (threshold at 24 KB; 25,300 B logged at 50-chunk mark) | [PERF-M5] at STREAM_BUFFERING -> STREAM_PLAYING transition
Dropped bytes | 0 bytes (no overflow observed) | Bytes discarded when ring is full (overflow)

⚠ C6 had a 160 KB STATIC flat buffer filled 99.95% in Session 4. S3’s ring buffer supports overflow-safe streaming — watch dropped byte count.

## M6 ESP32 Playback Start Delay

CAPTURED AT RUNTIME

Log tags to search:

- [PERF-M6] Playback start delay (buffering_start -> first_i2s_write): XXX ms (spk_init: XX ms)

Metric | Value | Notes / Meaning
Start marker received | measured | perfRxStartTime_ms set in ControlCallbacks (tag S)
Pre-buffer wait | ~(threshold / throughput) | Time to accumulate STREAM_START_THRESHOLD bytes
i2sSpkInit() time | 32 ms (from [PERF-M6] spk_init field) | New API channel create + init_std + enable
enableAmp() + delay | 30 ms | Fixed delay(30) before first i2s_channel_write
Total start delay | 551 ms (from [PERF-M6] log) | [PERF-M6] = perfStreamStartTime - perfRxStartTime

⚠ Unlike C6, S3 starts the speaker channel on-demand per session (not a teardown/reinstall of a shared bus). Expect similar or slightly faster init.

## M7 Total Round-Trip Latency

CAPTURED AT RUNTIME

Log tags to search:

- [PERF-M7] Total round-trip (PTT_release -> playback_end): XXXXX ms (XX.XX s) (S3_App_imp.ino)

Metric | Value | Notes / Meaning
PTT release | t = 0 | perfPttReleaseTime_ms set in loop()
Whisper | 8,582 ms | Session B — network + inference — see M1
GPT | 2,417 ms | Session B — network round-trip — see M2
TTS API + decode | 3,648 ms (TTS 2,954 + MP3 694) | Session B — Android CPU — see M3
BLE TX (Android→ESP32) | 2,591 ms (WRITE_NR) | Session A/B — WRITE_NR; see M4
ESP32 playback start | 551 ms | Pre-buffer + spk init + amp settle — see M6
TOTAL measured | ~18,100 ms (est.; [PERF-M7] tag not in log — calculated from pipeline + BLE TX + playback) | [PERF-M7] PTT_release → playback_end

⚠ C6 measured 16,512 ms (16.51 s) with WRITE_WITH_RESPONSE. S3 uses WRITE_NR and streaming playback — round-trip should be meaningfully lower.

## M8 I2S Speaker Init Time

CAPTURED AT RUNTIME

Log tags to search:

- [PERF-M8] I2S STD SPK channel enabled (I2S_NUM_1, independent from PDM mic on I2S_NUM_0)

Metric | Value | Notes / Meaning
Mic port | I2S_NUM_0 (PDM RX) | Always running — initialized once at boot, never stopped
Speaker port | I2S_NUM_1 (STD TX) | Initialized on-demand per playback session
Mode switch time | N/A | No mode switching required — independent hardware ports
Speaker init (create + enable) | 32 ms (from [PERF-M6] spk_init field) | Measured via timing around i2sSpkInit() call
Fixed delay (amp settle) | 30 ms | delay(30) after enableAmp() in streamPlaybackTick()

⚠ C6 had a single shared I2S peripheral requiring teardown/reinstall on every mic<->speaker switch (51 ms). S3 avoids this entirely with two independent ports.

## M9 BLE MTU Size Negotiated at Connection

CAPTURED AT RUNTIME

Log tags to search:

- [PERF-M9] BLE MTU negotiated: 512 bytes (audio payload/packet: 507 bytes) (S3_App_imp.ino)
- [PERF-M9] MTU negotiated: 512 bytes (audio payload/packet: 507 bytes) (BleVoiceService.kt)

Metric | Value | Notes / Meaning
Requested MTU | 512 bytes | BLE_MTU constant; TARGET_MTU in Android BleVoiceService
Actual negotiated MTU | 512 bytes (confirmed — both ESP32 and Android logs) | Confirmed by both Android + ESP32 logs on connect
ATT overhead | 3 bytes/packet | BLE ATT protocol overhead subtracted from MTU
Header overhead | 2 bytes/packet | TAG(1) + SEQ(1) per audio fragment
Max audio payload | MTU - 5 bytes | Effective audio bytes per BLE packet
@ MTU=512 | 507 bytes/pkt | 512 - 3 - 2 = 507 bytes of audio per packet

## M10 BLE Throughput During Audio Transfer

CAPTURED AT RUNTIME

Log tags to search:

- [PERF-M10] BLE TX throughput: XXXXX bytes/s (XX KB/s) MTU: 512 WRITE_NR (BleVoiceService.kt)
- [PERF-M10] BLE RX throughput: XXXXX bytes/s (XX KB/s) total: XXXXX bytes (S3_App_imp.ino)

Metric | Value | Notes / Meaning
TX throughput (Android) | 48,700 B/s (48.7 KB/s) | [PERF-M10] bytes / TX duration
RX throughput (ESP32) | ~49,800 B/s (~49.8 KB/s) [129,124 B ÷ 2,591 ms] | [PERF-M10] bytes / RX duration
Theoretical max @ MTU512 WRITE_NR | ~80–120 KB/s | 507 B × ~200 pkts/s — no ACK wait per packet
C6 result (WRITE_WITH_RESPONSE) | 15,195 B/s (14 KB/s) | Was only 35.9% of the 44.1 KB/s requirement
Audio requirement | 44,100 B/s | 22050 Hz × 16-bit mono — must exceed for real-time
Coverage ratio | 110.4% ✓ (48,700 ÷ 44,100 — above real-time requirement) | TX B/s ÷ 44,100 B/s — target >100% for streaming

⚠ C6 WRITE_WITH_RESPONSE only achieved 14 KB/s (35.9% of real-time requirement). S3 WRITE_NR is expected to achieve 60–120 KB/s, eliminating BLE as the dominant bottleneck.

## M11 Min and Max Utterance Length

CAPTURED AT RUNTIME

Log tags to search:

- [PERF-M11] PTT released — utterance: XXXX ms (X.XX s) ~XXXXX bytes (S3_App_imp.ino)
- [PERF-M11] Utterance received: XXXXX bytes X.XX s (BleVoiceService.kt)

Metric | Value | Notes / Meaning
Min utterance (time) | TBD — Session B | Shortest held PTT across sessions
Max utterance (time) | TBD — Session B | Longest held PTT across sessions
Min utterance (bytes) | TBD — Session B | MIN_AUDIO_BYTES = 16000 × 2 = 32,000 B (1 s minimum)
Sample rate (mic) | 16000 Hz | MIC_SR constant; PDM mic (MSM261D3526H1CPM)
Bit depth (mic BLE) | 16-bit | PDM RX outputs 16-bit directly (no >>16 shift needed)

## M12 Dead Time Between Playback and Next Record

STATIC / DESIGN

Log tags to search:

- [PERF-M12] Dead time (playback_end -> mic_ready): ~0 ms (S3_App_imp.ino)

Metric | Value | Notes / Meaning
Dead time | ~0 ms | PDM mic (I2S_NUM_0) never stops — independent from speaker (I2S_NUM_1)
Mic availability during playback | ACTIVE | Mic reads suppressed in loop() while streamState != IDLE
Speaker teardown | On finish: | stdTxHandle disabled + deleted after each playback session
Next record start | Immediately after streamState = STREAM_IDLE | No reinit needed; pdmRxHandle persists

⚠ C6 had 51 ms dead time due to shared I2S mode switching. S3 dead time is architecturally zero — the PDM mic channel never stops. The only gap is the loop() state check.

## M13 ESP32 RAM / PSRAM Usage at Key Moments

CAPTURED AT RUNTIME

Log tags to search:

- [PERF-M13][RAM] after-boot: free=XXXXXX B largest_block=XXXXXX B psram_free=XXXXX KB

Metric | Value | Notes / Meaning
After boot | free=305,084 B (297 KB), largest_block=249,844 B, psram=8,189 KB | Before camera, mic, or BLE init
After camera init | psram=8,158 KB (31 KB claimed by camera frame bufs; heap ~297 KB) | Camera PSRAM frame buffers claimed
After mic init | free=277,616 B (271 KB), psram=7,994 KB | [PERF-M13] after i2s_channel_enable PDM
After BLE init | free=213,804 B (208 KB), largest_block=172,020 B, psram=7,994 KB | [PERF-M13] after NimBLE GATT server start
On BLE connect | free=213,804 B (208 KB), psram=7,994 KB | [PERF-M13] in ServerCallbacks.onConnect()
On BLE MTU change | free=213,776 B (208 KB), psram=7,994 KB | [PERF-M13] in onMTUChange()
PTT pressed | TBD — Session B | [PERF-M13] in loop() fresh press branch
PTT released | TBD — Session B | [PERF-M13] before end marker sent
Start marker | TBD — Session A | [PERF-M13] in ControlCallbacks tag S
After playback | TBD — Session A | [PERF-M13] in streamPlaybackTick finish label
PSRAM total | 8,192 KB (8 MB — confirmed) | ESP32-S3 has 8 MB PSRAM; ring buffer + camera in PSRAM
Ring buffer (PSRAM) | 160 KB | ps_malloc(RING_SIZE) at boot
Camera frame bufs (PSRAM) | ~300–500 KB | fb_count=2, QVGA JPEG in PSRAM

## M14 Behavior When PTT Pressed During Playback

CAPTURED AT RUNTIME

Log tags to search:

- [PERF-M14] PTT pressed DURING playback! streamState=X ring_avail=XXXXX B (S3_App_imp.ino)
- [PERF-M14] Behavior: PTT press ignored — streaming state machine active; mic read skipped

Metric | Value | Notes / Meaning
Detection | in loop() before streamPlaybackTick() | Two-sample debounce on PTT_PIN
Action taken | log + return | Warning logged; streamPlaybackTick() still called
Mic availability | HW: ACTIVE SW: suppressed | PDM channel running but loop() does not read it
When mic becomes readable | After streamState = STREAM_IDLE | No reinit needed
Data loss | YES (same as C6) | Speech during playback captured but not transmitted

⚠ Same behavioral issue as C6: user speech during playback is lost. S3 improvement option: since mic HW is always active, implement a ring-capture buffer during playback and flush to Whisper after.

## M15 Audio Quality Parameters

STATIC / DESIGN

Log tags to search:

- [PERF-M15] AUDIO QUALITY PARAMETERS: (S3_App_imp.ino Serial output at boot)

Metric | Value | Notes / Meaning
Mic type | PDM built-in (MSM261D3526H1CPM) | XIAO ESP32-S3 Sense onboard mic
Mic sample rate | 16000 Hz | MIC_SR constant; standard telephony bandwidth
Mic I2S mode | PDM RX, I2S_NUM_0 | New IDF i2s_pdm_rx_config_t API
Mic bit depth | 16-bit | I2S_DATA_BIT_WIDTH_16BIT; direct output (no shift needed)
Mic DC filter | Software HP filter | y[n] = x[n] - x[n-1] + 0.995*y[n-1]; gain=10
Mic channel format | MONO | I2S_SLOT_MODE_MONO from MSM261D PDM
Speaker sample rate | 22050 Hz | SPK_SR constant
Speaker I2S mode | STD TX, I2S_NUM_1 | New IDF i2s_std_config_t API, Philips format
Speaker bit depth | 16-bit | I2S_DATA_BIT_WIDTH_16BIT; adequate for TTS
Speaker channel format | STEREO (L=R) | Both channels driven with same mono sample for dual-amp
Pre-buffer threshold | 24,000 B (~544 ms) | STREAM_START_THRESHOLD before playback starts
TTS format | MP3, tts-1, nova | Decoded client-side with Android MediaCodec
TTS final PCM | 22050 Hz mono 16-bit | After decodeMp3ToPcm() + optional resample

## M16 Power Consumption Analysis

STATIC / DESIGN

Values derived from Espressif ESP32-S3 datasheet, MSM261D3526H1CPM datasheet, OV3660 datasheet, and MAX98357A datasheet combined with firmware analysis. Runtime capture not yet performed.

Metric | Value | Notes / Meaning
ESP32-S3 CPU @ 240 MHz | ~95 mA | Higher than C6 (85 mA) due to faster core
BLE @ +9 dBm, connected idle | ~15 mA avg | Same NimBLE stack as C6
BLE @ +9 dBm, high TX/RX (WRITE_NR) | ~20 mA avg | Lower than C6 WRITE_WITH_RESPONSE due to shorter bursts
PDM mic (MSM261D) | ~0.6 mA | Lower than INMP441 (1.4 mA) on C6
OV3660 camera (idle/active) | ~5 / ~40 mA | Active during capture + warmup (~500 ms per snap)
MAX98357A (quiescent) | 2.4 mA | No SD pin gate in firmware — same issue as C6
MAX98357A (playback) | ~35 mA avg | ~100 mW audio output at 3.3 V
Estimated avg (50% idle) | ~160–185 mA | Higher than C6 (~115 mA) due to camera subsystem
300 mAh LiPo | ~1.7–1.9 hours | Worse than C6 (2.6 h) due to camera overhead
Power optimization potential | ~60–70 mA saved | CPU scaling + BLE power + amp SD pin + camera power gate

⚠ Camera subsystem increases average draw vs C6. Implement OV3660 power-down between captures (PWDN pin if wired) and MAX98357A SD pin gating to reduce idle current.

## M17 Camera Capture Time (NEW — S3 only)

CAPTURED AT RUNTIME

Log tags to search:

- [PERF-M17] Camera capture time: XXXX ms size: XXXXX bytes (XX KB) (S3_App_imp.ino)

Metric | Value | Notes / Meaning
Capture time | TBD — Session A | millis() around esp_camera_fb_get() + ps_malloc + memcpy
Frame size | QVGA (320×240) | FRAMESIZE_QVGA config in initCamera()
JPEG quality | 12 | jpeg_quality=12 (lower = smaller file)
Expected JPEG size | ~7.6 KB measured (7,614 bytes derived from Image RX: 282 ms × 27 KB/s) | Typical QVGA JPEG; actual depends on scene complexity
Retry logic | Up to 5 attempts | 150 ms between retries; typical good capture on attempt 1–2
Warm-up frames | 5 discarded | 100 ms each during boot to let AEC/AWB converge
Frame buffer location | PSRAM | config.fb_location = CAMERA_FB_IN_PSRAM

## M18 Image BLE TX Time (NEW — S3 only)

CAPTURED AT RUNTIME

Log tags to search:

- [PERF-M18] Image BLE TX: XXXX ms XXXXX bytes XXX packets throughput: XXXXX B/s (S3_App_imp.ino)

Metric | Value | Notes / Meaning
Image TX duration | 282 ms | millis() around sendCapturedImage() call
Total bytes | ~7,614 bytes (~7.6 KB) | capturedJpegLen — depends on scene
Packet count | ~15 packets (7,614 ÷ 507 B/pkt) | JPEG fragmented at BLE_MAX_PAYLOAD (507 B) per notify
Inter-packet delay | 15 ms | delay(15) per fragment to prevent notification drops
Throughput | 27,000 B/s (27 KB/s) | JPEG size / TX duration
Channel | IMAGE_TX (NOTIFY) | Characteristic 0000aa04; separate from audio path

⚠ Image TX uses NOTIFY (not WRITE) so no ACK wait. The 15 ms inter-packet delay is conservative; reducing to 10 ms may improve speed without drops.

## M19 Streaming Underrun Rate (NEW — S3 only)

CAPTURED AT RUNTIME

Log tags to search:

- [PERF-M19] Streaming underruns: X / XXXX chunks (X.X%) (S3_App_imp.ino)

Metric | Value | Notes / Meaning
Total playback chunks | ~255 chunks (129,124 B ÷ 507 B/chunk) | Incremented each i2s_channel_write call
Underrun count | 0 (ring remained positive throughout session) | Ring below wantBytes; silence inserted
Underrun rate | 0% (no underruns observed) | underruns / total_chunks × 100%
Target | < 1% | Above 1% indicates BLE jitter or throughput issue
Low-water mark | 2,048 B | STREAM_LOW_WATER; underrun logged when ring dips below wantBytes
Re-buffer wait | Up to 60 ms | Busy-yield loop in STREAM_PLAYING before giving up

⚠ Unlike C6 (buffer-all-then-play), S3 streams during receive. Underruns indicate BLE jitter or throughput drops. A high underrun rate implies WRITE_NR packets arriving too slowly.

# 4. Bottleneck Analysis & Recommendations

## 4.1 Expected Latency Improvement Over C6

Based on the S3 architectural changes, the following improvements are anticipated before any runtime data is collected:

# | Bottleneck | C6 Result | S3 Expectation

1 | BLE audio TX (WRITE_WITH_RESPONSE → WRITE_NR) | 10,574 ms (64% of RTT) | 2,000–3,000 ms estimate
2 | I2S mode switch dead time | 51 ms per cycle | 0 ms (independent ports)
3 | Buffer overflow risk (flat buffer) | 99.95% full | Ring buffer: overflow-safe streaming
4 | OpenAI pipeline (Whisper+GPT+TTS) | 7,754 ms (same app) | ~7,754 ms (no change expected)

## 4.2 RAM / PSRAM Concerns

- ESP32-S3 has 512 KB internal DRAM + 8 MB PSRAM (XIAO Sense).
- Ring buffer (160 KB) and camera frame buffers (~300–500 KB) are PSRAM-backed via ps_malloc().
- NimBLE stack requires ~60–90 KB internal DRAM.
- Monitor psram_free alongside free heap at each M13 checkpoint.
- If PSRAM free drops below 1 MB, consider reducing fb_count from 2 to 1 (saves ~75 KB).

## 4.3 Streaming Underrun Risk

- The STREAM_START_THRESHOLD (24,000 B ≈ 544 ms) is the pre-buffer before playback begins.
- If BLE throughput is too low to sustain 44,100 B/s, underruns will occur despite the buffer.
- Target: BLE TX > 44,100 B/s (WRITE_NR is expected to achieve 60–120 KB/s — above requirement).
- If underrun rate > 1%, increase STREAM_START_THRESHOLD or reduce inter-packet delay(8) to delay(5).

## 4.4 Camera Power & Latency

- OV3660 warm-up (5 × 100 ms = 500 ms) is performed at boot, not per capture.
- Each double-press capture adds M17 time to the round-trip before audio TX begins.
- If PWDN pin is wired, implement camera power-down between captures to reduce idle draw.

## 4.5 PTT-During-Playback UX Issue

Same issue as C6: pressing PTT during playback is logged but ignored. The S3 has a hardware advantage: the PDM mic is always running on I2S_NUM_0. A future improvement could capture audio to a secondary ring buffer during playback and process it after STREAM_IDLE.

# 5. Log Tag Quick Reference

Use these tags with adb logcat or grep in the ESP32 serial output:

Log Tag | Metric | Source | What It Captures
[PERF-M1] | M1 | VoicePipeline (Android) | Whisper time, total pipeline time
[PERF-M2] | M2 | VoicePipeline (Android) | GPT API response time
[PERF-M3] | M3 | VoicePipeline (Android) | TTS API time + MP3 decode time
[PERF-M4] | M4 | BleVoiceService + .ino | TX/RX start, end, duration
[PERF-M5] | M5 | S3_App_imp.ino | Ring buffer fill % and overflow
[PERF-M6] | M6 | S3_App_imp.ino | Start-marker to first i2s_channel_write
[PERF-M7] | M7 | S3_App_imp.ino | PTT release to playback end
[PERF-M8] | M8 | S3_App_imp.ino | I2S STD speaker channel init (no mode switch)
[PERF-M9] | M9 | BleVoiceService + .ino | Negotiated MTU bytes
[PERF-M10] | M10 | BleVoiceService + .ino | TX/RX throughput bytes/s
[PERF-M11] | M11 | BleVoiceService + .ino | Utterance min/max length
[PERF-M12] | M12 | S3_App_imp.ino | Dead time (expected ~0 ms)
[PERF-M13] | M13 | S3_App_imp.ino | Free heap + PSRAM at 9+ key moments
[PERF-M14] | M14 | S3_App_imp.ino | PTT-during-playback event
[PERF-M15] | M15 | S3_App_imp.ino | Sample rates, bit depth, config at boot
[PERF-M16] | M16 | S3_App_imp.ino | Power consumption note (static)
[PERF-M17] | M17 | S3_App_imp.ino | Camera capture time + JPEG size
[PERF-M18] | M18 | S3_App_imp.ino | Image BLE TX duration + throughput
[PERF-M19] | M19 | S3_App_imp.ino | Streaming underrun count + rate

Sessions to be captured on XIAO_ESP32S3 Sense (branch: perf-instrumentation-s3). All RUNTIME entries pending hardware capture. M12, M15, and parts of M16 are STATIC/DESIGN and do not require runtime sessions.

S3_App_imp | Performance Metrics Report Branch: perf-instrumentation-s3 | Date: 2026-04-13
