IbrahimAyoub05/AIglasses/PCB/AIglasses.kicad_sch

## KiCad design PCB/AIglasses.kicad_sch (2026-06-15)

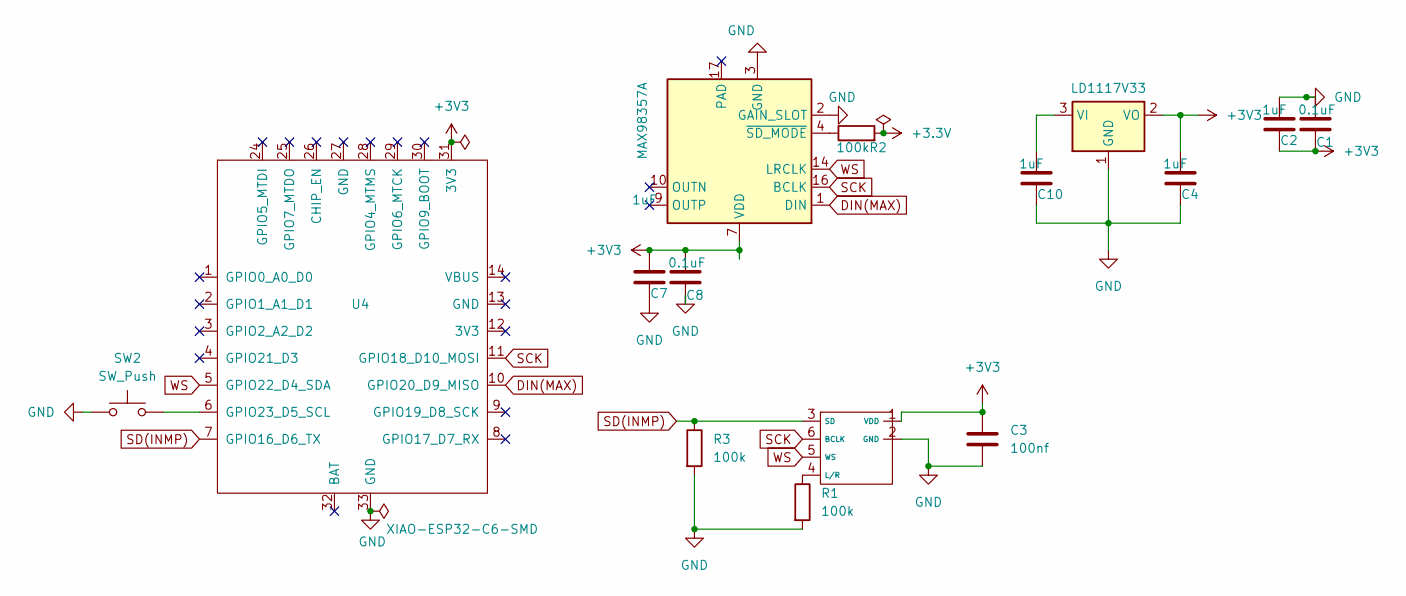
[picture p51: schematic AIglasses.kicad_sch]

Parts:
C1, C8: 0.1uF
C2, C4, C7, C10: 1uF
C3: 100nf
R1, R2, R3: 100k
SW2: SW_Push
U2: (no value)
U3: LD1117V33; TO-220-3_Vertical
U4: XIAO-ESP32-C6-SMD
U5: MAX98357A; TQFN-16-1EP_3x3mm_P0.5mm_EP1.23x1.23mm

Connections:
+3.3V: R2.2
+3V3: C1.2, C2.2, C3.1, C4.1, C7.1, C8.1, U2.1 (VDD), U3.2 (VO), U4.31 (3V3), U5.7 (VDD), U5.8 (VDD)
DIN(MAX): U4.10 (GPIO20_D9_MISO), U5.1 (DIN)
GND: C1.1, C2.1, C3.2, C4.2, C7.2, C8.2, C10.2, R1.2, R3.2, SW2.1, U2.2 (GND), U3.1 (GND), U4.33 (GND), U5.2 (GAIN_SLOT), U5.3 (GND), U5.11 (GND), U5.15 (GND)
unnamed: C10.1, U3.3 (VI)
unnamed: R1.1, U2.4 (L/R)
unnamed: R2.1, U5.4 (~SD_MODE)
unnamed: SW2.2, U4.6 (GPIO23_D5_SCL)
SCK: U2.6 (BCLK), U4.11 (GPIO18_D10_MOSI), U5.16 (BCLK)
SD(INMP): R3.1, U2.3 (SD), U4.7 (GPIO16_D6_TX)
WS: U2.5 (WS), U4.5 (GPIO22_D4_SDA), U5.14 (LRCLK)
