IbrahimAyoub05/AIglasses/(commit log)

2026-02-25 Improve audio quality: larger DMA buffers, APLL clock, and sinc resampler
    ESP32 firmware:
    - Enable APLL (use_apll=true) for jitter-free I2S clock on speaker
    - Increase DMA buffers from 8×512 to 16×1024 (~743ms headroom) to
    eliminate buffer-underrun buzzing/clicks
    Android pipeline:
    - Fix stereoToMono integer overflow (widen Short to Int before averaging)
    - Replace linear interpolation resampler with windowed-sinc (Hann window,
    16-tap half-width) to remove aliasing buzz when downsampling from
    24000Hz → 22050Hz
2026-02-25 Add dual-speaker support via I2S true-stereo interleaving
    - Switch speaker I2S from ONLY_LEFT to RIGHT_LEFT (true stereo) so both
    I2S slots are driven on every frame
    - AMP1 (LR/GAIN=GND) reads left slot, AMP2 (LR/GAIN=3.3V) reads right slot
    - playSpeaker() now expands mono PCM into interleaved L=R stereo chunks
    before i2s_write(), giving both amps the same audio signal
    - Add stereoChunk[STEREO_CHUNK_MONO*2] static buffer for the expansion
2026-03-18 Fix idle speaker buzz and add missing TTS speak() method
    - Drive AMP_DIN LOW in mic mode to silence MAX98357A when I2S bus
    is in RX mode (floating DIN caused buzzing from shared BCLK/WS)
    - Add OpenAI TTS speak() method to OpenAIService.kt (was missing,
    caused "Unresolved reference" build error)
    - Add playback debug diagnostics (DC offset, sample range, DMA writes)
2026-03-20 BLE optimization: WRITE_NR, anti-buzz measures, and packet loss tracking
    - Switch BLE audio RX from WRITE to WRITE_NR for max throughput
    - Force AMP_DIN LOW before I2S teardown to prevent floating pin buzz
    - Disable APLL (C6 buzzes at 22050Hz with it)
    - Add fade-out on last 50ms of audio to avoid abrupt cutoff pop
    - Flush 8 silence chunks + i2s_stop() for clean DMA drain
    - Add BLE sequence number tracking to detect WRITE_NR packet loss
    - Buffer overflow: play truncated audio instead of dropping silently
    - Even-align BLE payload size to prevent 16-bit sample misalignment
    - Reset playAudio flag on Start marker to prevent stale overflow state
2026-04-07 Fix vision mode ordering: ESP32 sends image before audio END marker
2026-04-07 Add ESP32-S3 firmware with camera + vision mode
2026-04-07 Re-encode camera image as PNG for OpenAI vision API compatibility
2026-04-07 Remove unused files: root .idea, kicad schematic, C6Imp, servert.py
    [AIglasses.kicad_sch]
2026-04-13 Fix camera capture: add sensor warm-up and retry logic
    esp_camera_fb_get() returns NULL until AEC/AWB loops converge
    after clock start (~500ms). Added 5 warm-up frame discards in
    initCamera() and up to 5 retries with 150ms delays in captureSnapshot().
2026-04-13 Move camera init before mic/PSRAM to fix DMA channel conflicts
    esp_camera_fb_get() returned NULL on every attempt because the PDM
    mic (I2S_NUM_0) and 160KB ring buffer were initialized first, claiming
    DMA channels and fragmenting PSRAM before the camera driver could
    allocate its frame buffers. Moving camera init to run first in setup()
    gives it clean access to DMA and contiguous PSRAM. Added PSRAM
    diagnostics to serial output for debugging.
2026-04-22 Fix S3 speaker GPIO pins to match PCB design, disable camera
    - Update I2S_BCLK, I2S_WS, AMP_DIN to GPIO18/22/20 (matching C6 PCB layout)
    - Disable camera init: GPIO18 (CAM_Y4) conflicts with speaker BCLK on this PCB rev
    - Camera will be re-enabled after next PCB revision resolves the pin conflict
2026-04-22 Change S3 PTT button to active high
2026-04-22 Update S3 speaker/PTT pins to match new PCB footprint, re-enable camera
    Speaker now on BCLK=GPIO9, WS=GPIO5, DIN=GPIO8; PTT moved to GPIO6.
    GPIO18 freed for camera D2, so camera init is restored.
2026-04-27 Fix S3 speech cut-outs and low volume
    - SPK_VOL_SHIFT 2→1: doubles speaker output (-12dB → -6dB)
    - STREAM_START_THRESHOLD 24000→35000: pre-buffer ~800ms to absorb BLE jitter
    - Underrun wait 60ms→120ms: more time to recover before inserting silence
2026-05-18 Full UI redesign: liquid glass design language with 5 screens
    Redesigns the companion app with a premium dark-only "liquid glass" aesthetic
    inspired by Apple Vision Pro / iOS 26. Implements a complete component library
    and multi-screen navigation while preserving the existing BLE/AI service layer.
    Key changes:
    - 10 reusable glass-effect components (GlassCard, StatusBadge, GlassDock, etc.)
    - 5 screens: Home, Live View, Features, Settings, Developer (hidden)
    - MainViewModel with StateFlow-based state management
    - Compose Navigation with animated transitions
    - Dark-only theme with Apple system color palette
    - API 24+ compatible glass effect (Canvas gradients, no Modifier.blur)
    [MainViewModel.kt]
2026-05-18 Fix degraded image quality in gallery thumbnails and full-screen viewer
    Reduce thumbnail inSampleSize from 4 to 2 for sharper grid tiles, and add
    FilterQuality.High to the full-screen Image composable to eliminate upscale blur.
2026-05-18 Load thumbnails at full resolution with high-quality filtering
2026-05-18 Add delete button to thumbnails and fix viewer buttons hidden by status bar
2026-05-18 Lower viewer action buttons further below status bar
2026-06-04 Add [PERF-Mxx] performance instrumentation for S3 test session
    Mirrors the previous C6 and S3 test methodology with tagged log lines
    filterable via grep or adb logcat. Adds new camera and microphone
    diagnostic metrics to investigate known inconsistency issues.
    Firmware (S3_App_imp.ino):
    M1 Mic BLE TX: bytes, chunks, throughput (ESP32 -> Android)
    M4 TTS BLE RX start with heap snapshot
    M5 Ring buffer fill % at playback start
    M6 'S' marker -> first I2S write latency
    M7 Button press -> playback start (end-to-end round-trip)
    M8 Speaker I2S init duration
    M10 BLE RX throughput (Android -> ESP32)
    M11 Utterance: bytes, duration, chunk count
    M13 Heap + PSRAM at boot / camera /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
2026-06-04 Fix camera capture inconsistency and image reassembly failures
    Two distinct bugs behind the "camera sometimes doesn't take / doesn't
    reassemble" symptom:
    1. Capture (firmware S3_App_imp.ino):
    - captureSnapshot() return value was ignored in loop(); a failed
    capture left visionMode=true with a null JPEG, so the glasses sent
    audio with no image silently. Now falls back to voice-only + logs.
    - Added a stale-frame flush (grab+discard, then grab) before capture
    so CAMERA_GRAB_LATEST + fb_count=2 can't return an old idle frame.
    2. Reassembly (firmware + Android):
    - pImageTxChar->notify() return was ignored; NimBLE drops the packet
    silently (BLE_HS_ENOMEM) when the TX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
2026-06-04 Decouple photo capture from question; fix blank images
    Validated on hardware: captures every time, images look correct, image
    reassembly clean (retries=0 dropped=0, no corrupt transfers).
    Gesture rework:
    - Quick double-tap = standalone photo: captured on 2nd press, sent
    without an audio END marker. App stores it, always saves to gallery,
    and opens a 5s window.
    - Single press + hold = voice question; app auto-attaches a photo taken
    within the last 5s (VISION_WINDOW_MS), else voice-only.
    - Double-tap + hold = photo + question bundled (kept as a shortcut).
    - Triple-tap + hold = video (unchanged).
    Blank-image fix:
    - Warm up the sensor (discard 4 frames w/ 20ms spacing) so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
    [MainViewModel.kt]
2026-06-04 Fix mic mis-transcription: kill clipping, normalize, upgrade STT
    Validated on hardware: 5 questions in a row transcribed correctly.
    Root cause was the firmware mic gain clipping loud/normal speech
    (peak=32768 → distortion → Whisper hallucinating confident nonsense
    like "this is the best sport in the world").
    - MIC_GAIN 10 → 1. Raw mic is already 16-bit so gain=1 cannot clip;
    all leveling moved to the Android side. (10x and 4x both clipped.)
    - Fixed stale startup banner: "Running on C6 PCB" → "XIAO ESP32-S3".
    App:
    - VoiceAssistantPipeline: normalizeForAsr() peak-normalizes each
    utterance to ~22000 (cap 12x, silence guard) before Whisper, so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
2026-06-09 Add video support to gallery; enable vision feature by default
    - SavedImage gains isVideo flag to distinguish videos from images
    - Gallery shows separate image/video counts, extracts first-frame thumbnails
    for videos via MediaMetadataRetriever, and overlays a play badge
    - ImageViewer adds a Play Video button that opens the system video player
    via FileProvider intent; delete dialog title adapts to media type
    - File size label upgrades from KB-only to MB when file exceeds 1 MB
    - FileProvider registered in AndroidManifest with file_paths.xml exposing
    the gallery/ directory for secure URI sharing
    - Vision feature enabled by default; removed BLE-disconnect lock on vision
2026-06-10 Remove performance-test instrumentation; switch video to triple-tap
    Strip all [PERF-Mxx] markers and [MIC] amplitude debug logging that were
    added for the S3 performance test session — the perf state variables,
    per-frame/per-chunk timing, throughput logs, and heap/PSRAM boot prints.
    Functional logging ([STREAM], [BLE], [PTT], [CAM], [SYS]) and the
    underrun-detection logic are retained.
    Also change the video gesture from quick single-tap to quick triple-tap
    to start (single tap still stops), so single/double taps no longer
    trigger recording by accident.
    Remove obsolete C6_App_imp/ sketch and Doccumentation/ folder.
2026-06-11 Add S3_App_V2 modular firmware; fix gesture hold debounce and update Android app
    Replaces the monolithic S3_App_imp with a 7-module firmware (audio_io, ble_link,
    camera_ctl, gestures, playback, ring_buffer, status_led). Key fixes over V1:
    - Gesture: defer GESTURE_PRESS_VOICE/VISION to 350 ms hold confirmation so quick
    taps no longer send spurious 'S' start markers that clear the audio buffer and
    cut off the first ~250 ms of the real utterance
    - BLE: notifyWithRetry on all send paths; static packet buffer replaces VLA
    - Playback: PSRAM ring buffer, 70 KB pre-buffer, 4 s stall watchdog, barge-in
    - Mic: DMA flush before each recording to drop stale pre-roll
    - Camera: deferred photo send so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
    [MainViewModel.kt, S3_App_V2.ino]
2026-06-15 Clean up repo: add CAD, docs, PCB; drop old C6 firmware
    [AIglasses.kicad_sch, Arm1.stl, ArmCover.stl, ArmCovers_CoverLeft v1.3mf, ArmCovers_CoverLeft v1.stl, ArmCovers_CoverRight v1.3mf, ArmCovers_CoverRight v1.stl, ArmLeft1.stl]
